scarletnova20/Power_Distribution_Board/engineering/release50/lioncircuits_review/drill/drill_report.txt

Drill report for PDB_50A.kicad_pcb
Created on 2026-09-11T23:52:39

Copper Layer Stackup:
    =============================================================
    L1 :  F.Cu                      front
    L2 :  In1.Cu                    in1
    L3 :  In2.Cu                    in2
    L4 :  B.Cu                      back

Drill file 'PDB_50A-PTH.drl' contains
    plated through holes:
    =============================================================
    T1  0.300mm  0.0118"  (343 holes))
    T2  1.000mm  0.0394"  (12 holes))

    Total plated holes count 355

Drill file 'PDB_50A-NPTH.drl' contains
    unplated through holes:
    =============================================================
    T1  3.200mm  0.1260"  (4 holes))

    Total unplated holes count 4
