scarletnova20/Power_Distribution_Board/engineering/back.png

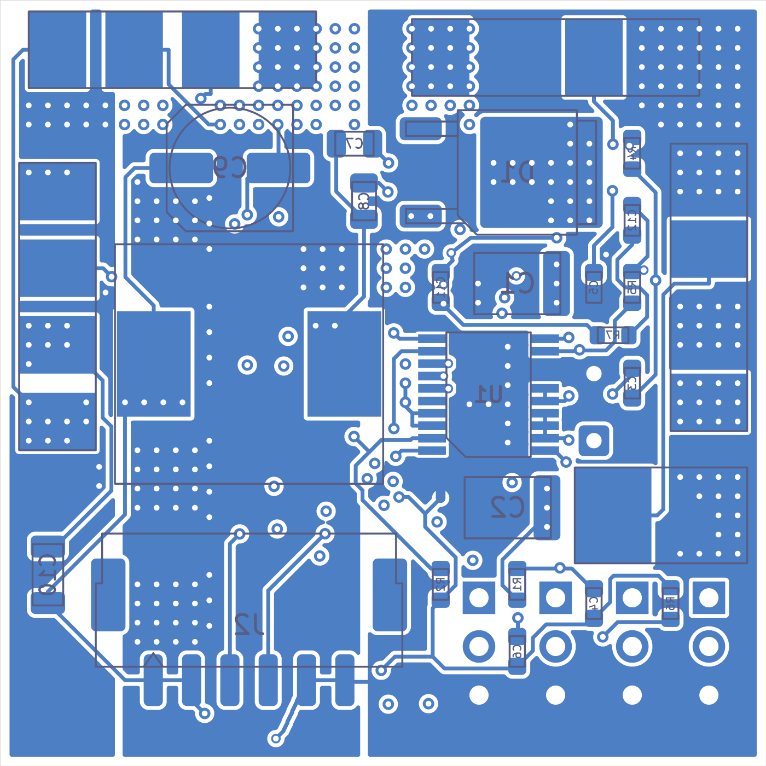
engineering/back.png
