scarletnova20/Power_Distribution_Board/engineering/datasheets/isc027n10nm6_5.png

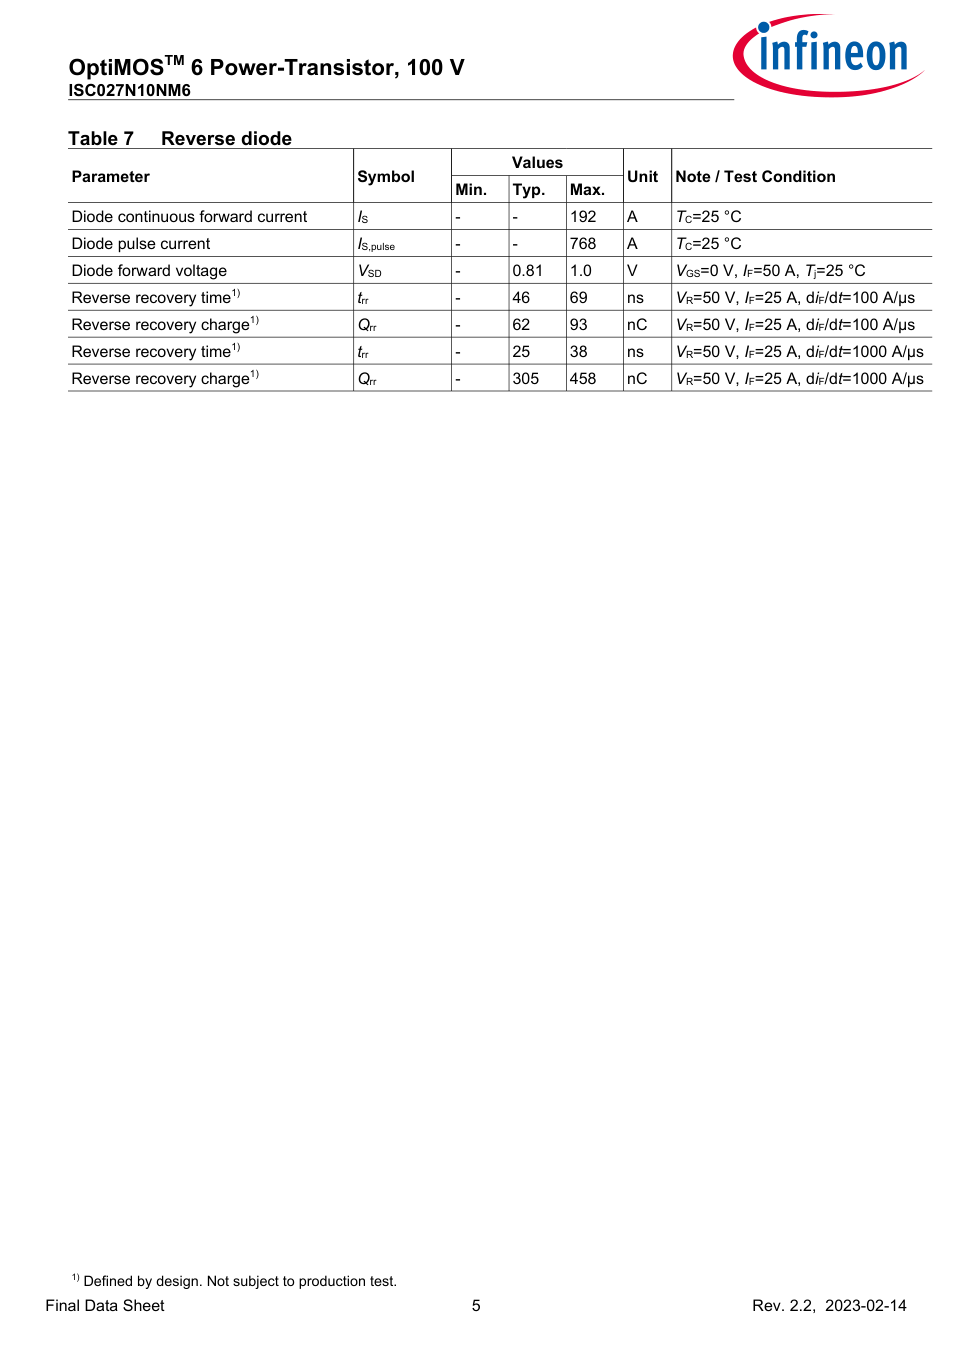
engineering/datasheets/isc027n10nm6_5.png
