scarletnova20/Power_Distribution_Board/engineering/datasheets/lm74502_12.png

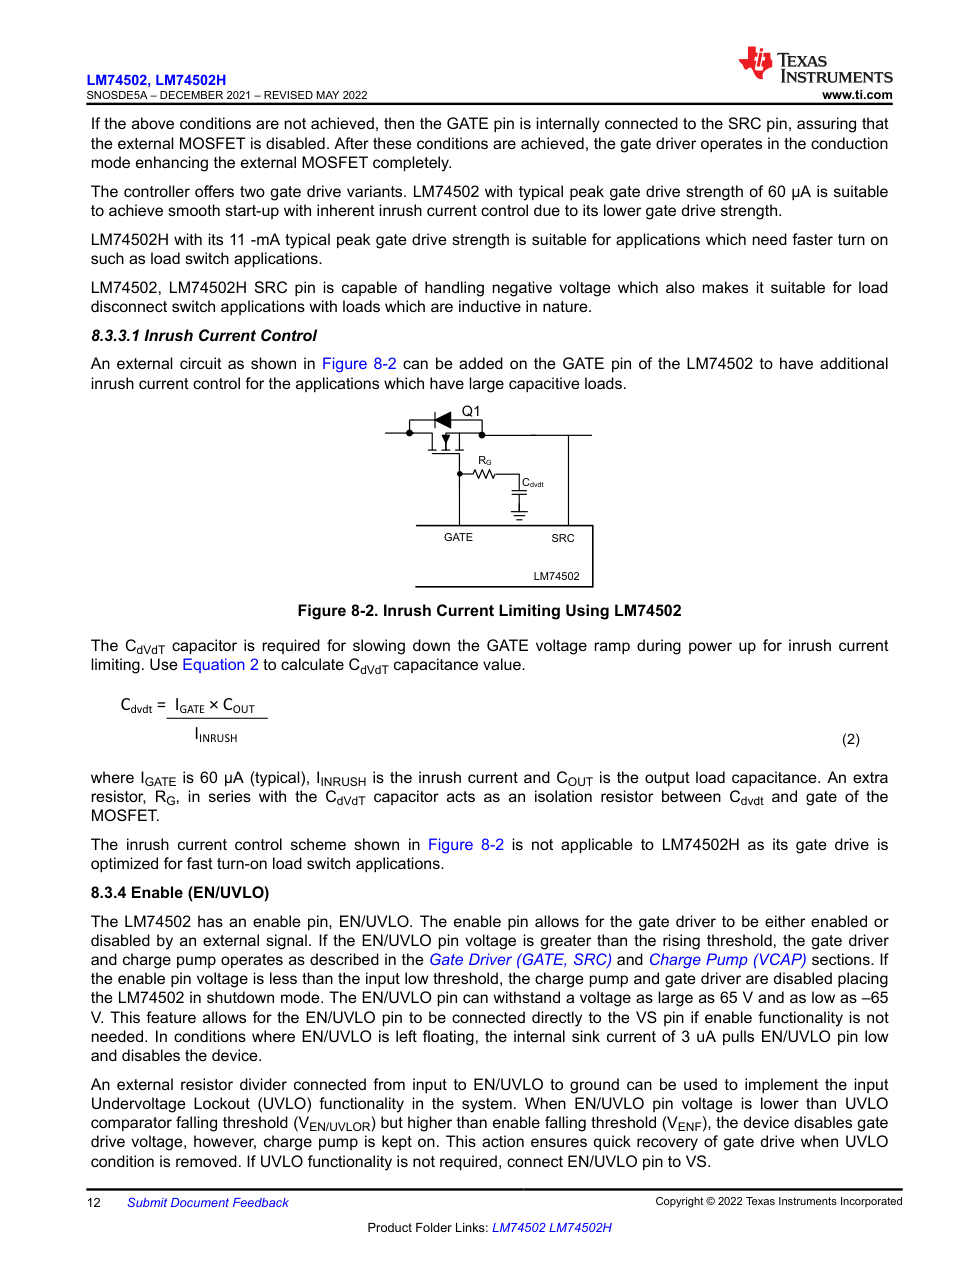
engineering/datasheets/lm74502_12.png
