scarletnova20/Power_Distribution_Board/engineering/datasheets/lm74502_27.png

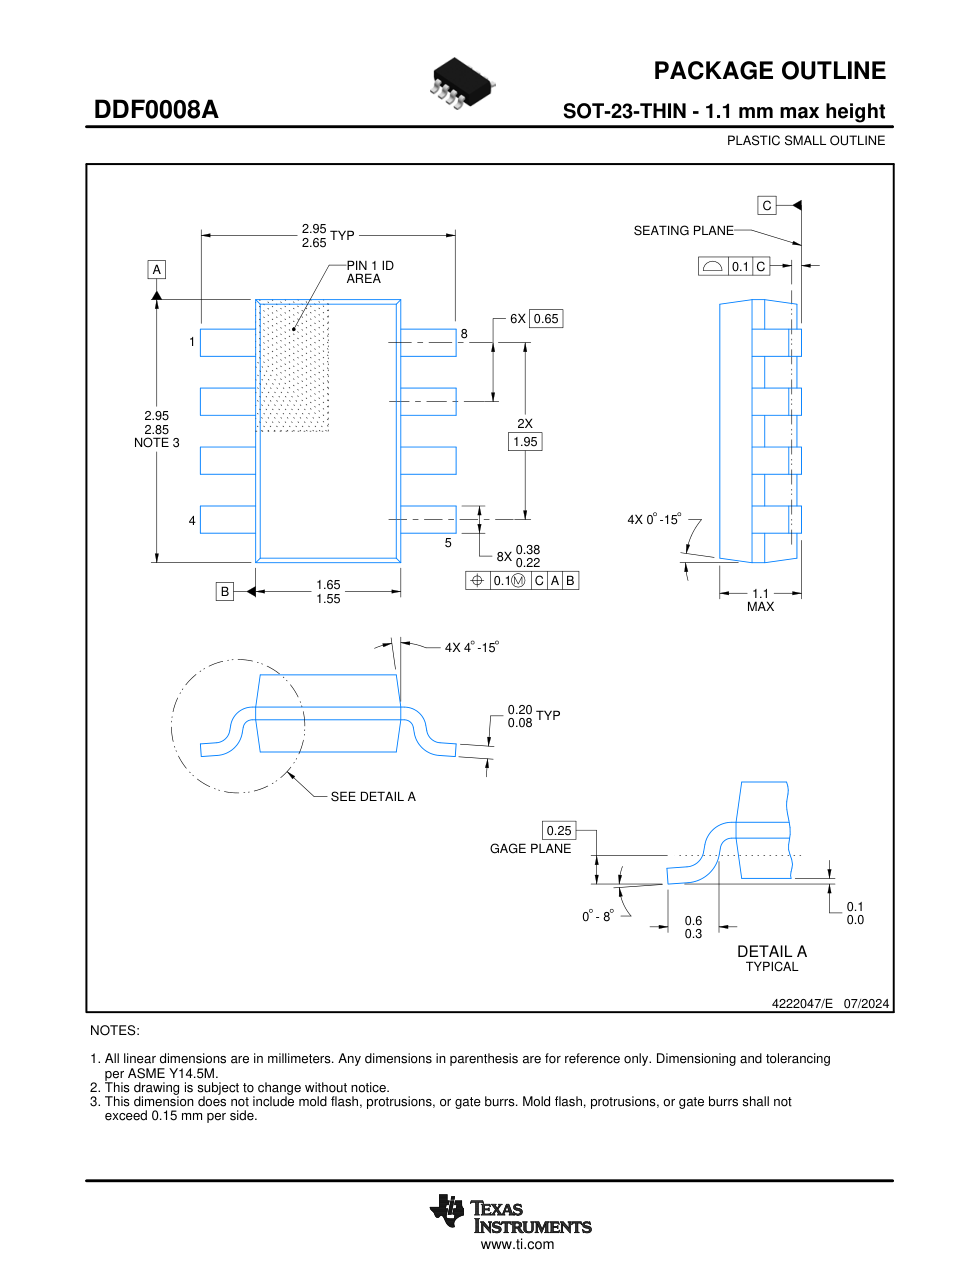
engineering/datasheets/lm74502_27.png
