scarletnova20/Power_Distribution_Board/engineering/front.png

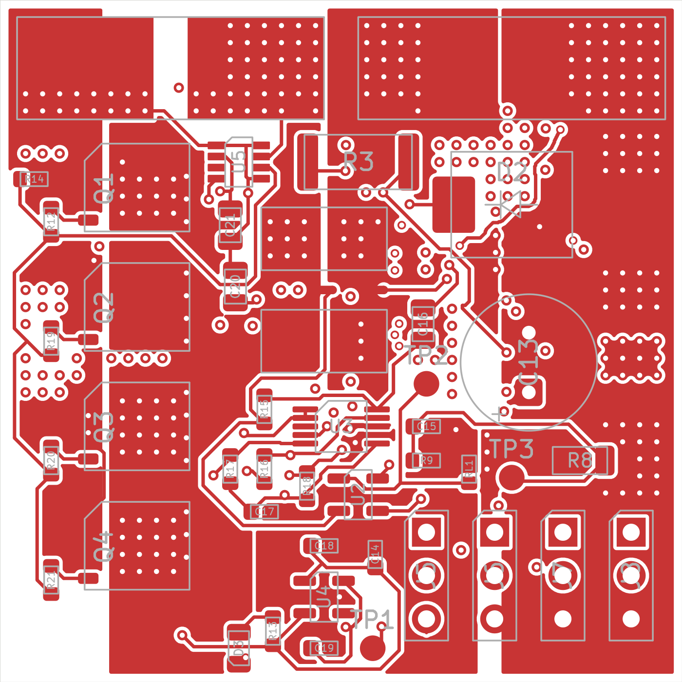
engineering/front.png
