scarletnova20/Power_Distribution_Board/engineering/local.png

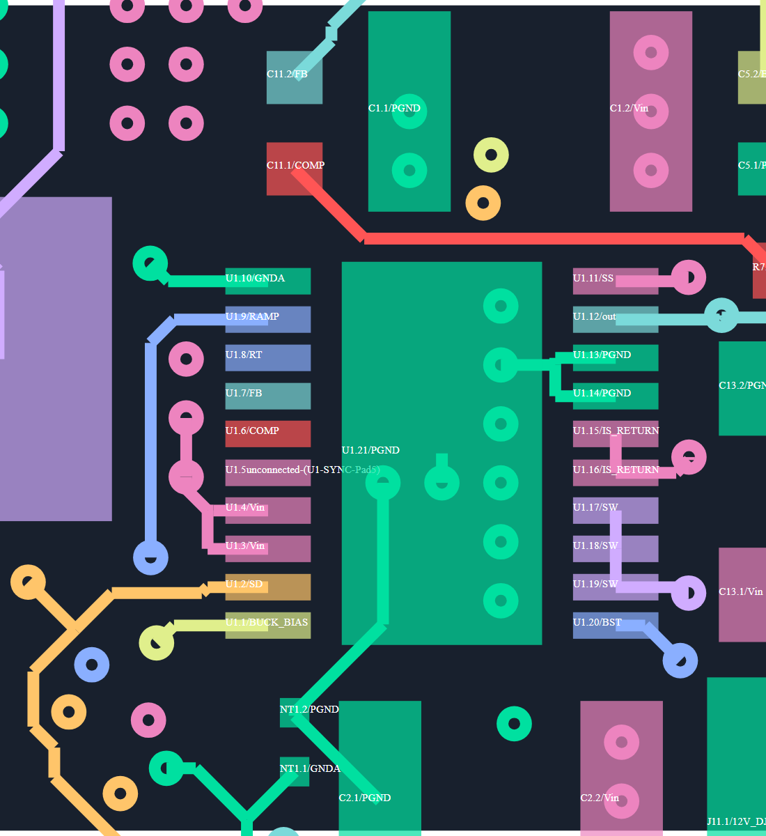
engineering/local.png
