scarletnova20/Power_Distribution_Board/engineering/release42/back.png

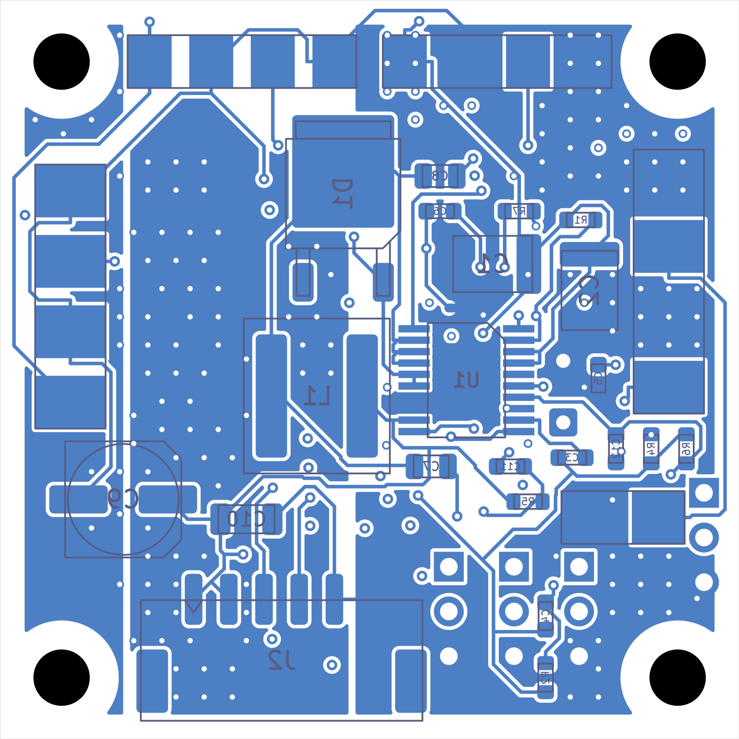
engineering/release42/back.png
