scarletnova20/Power_Distribution_Board/engineering/release42/copper_review/release_candidate-B_Cu.png

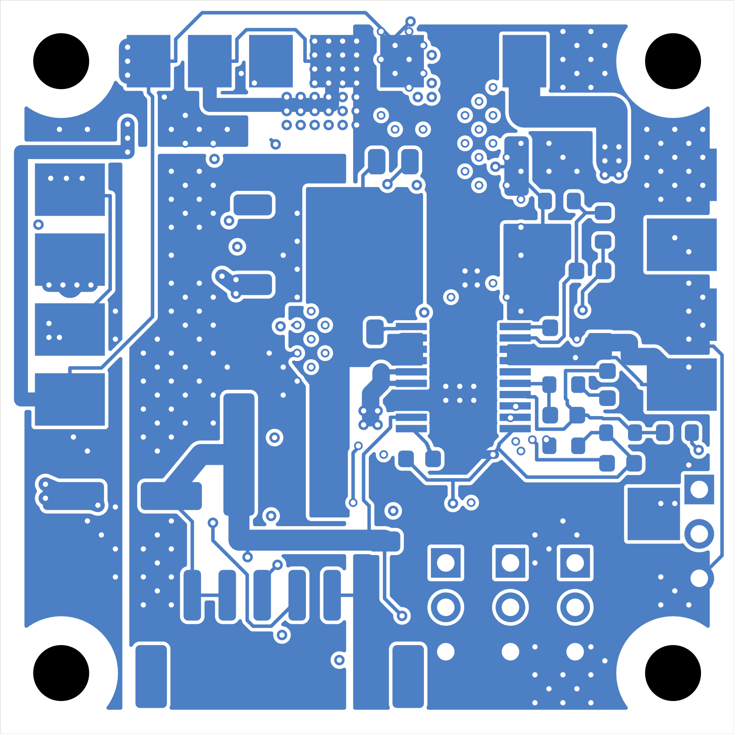
engineering/release42/copper_review/release_candidate-B_Cu.png
