scarletnova20/Power_Distribution_Board/engineering/release42/copper_review/release_candidate-In2_Cu.png

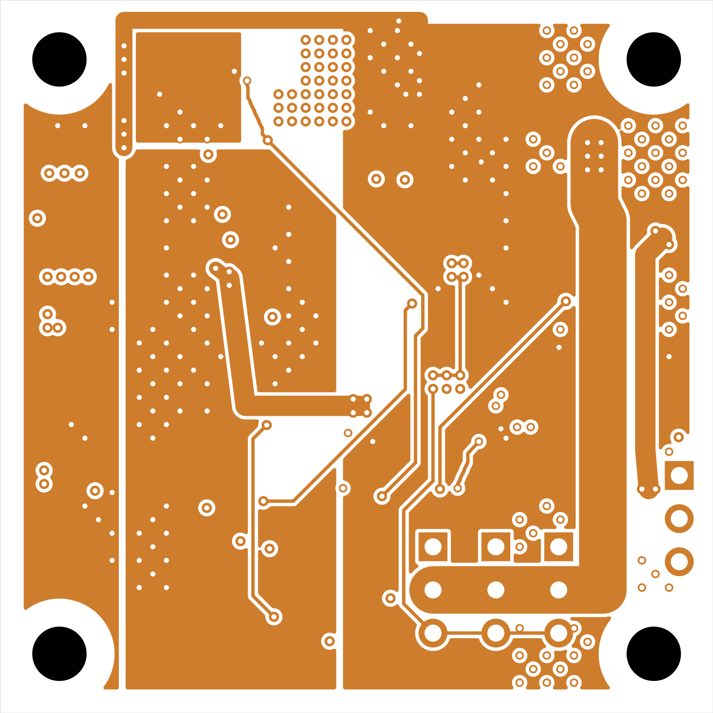
engineering/release42/copper_review/release_candidate-In2_Cu.png
