scarletnova20/Power_Distribution_Board/engineering/release42/front.png

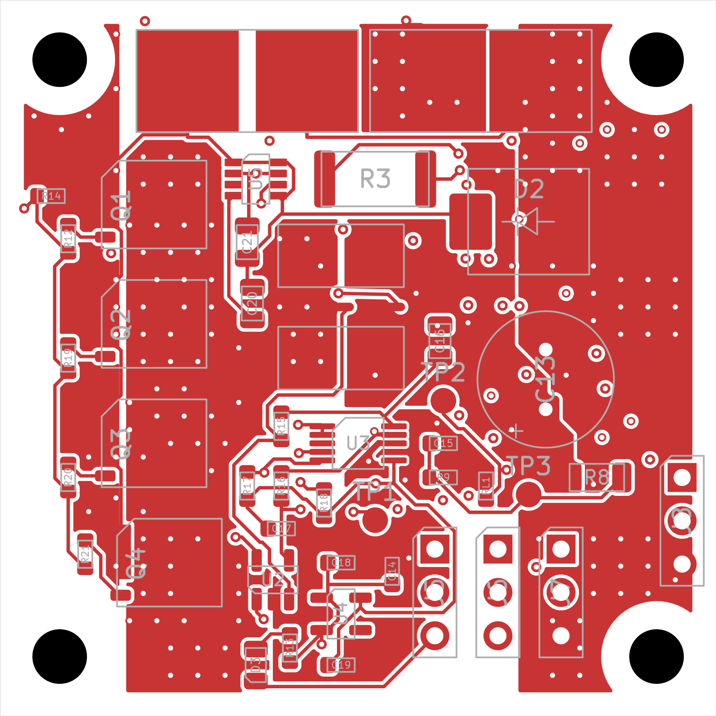
engineering/release42/front.png
