scarletnova20/Power_Distribution_Board/engineering/release42/led_review/schematic/release_candidate.png

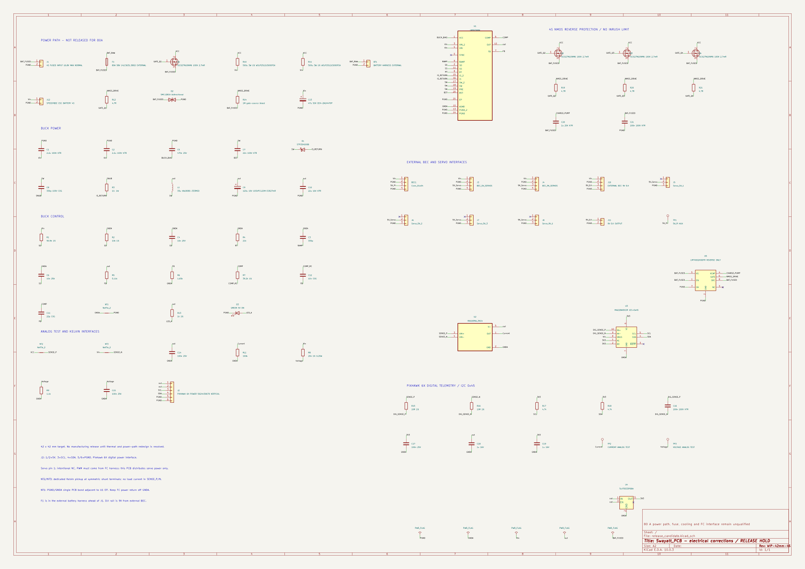
engineering/release42/led_review/schematic/release_candidate.png
