scarletnova20/Power_Distribution_Board/engineering/release42/lm5576_p36.png

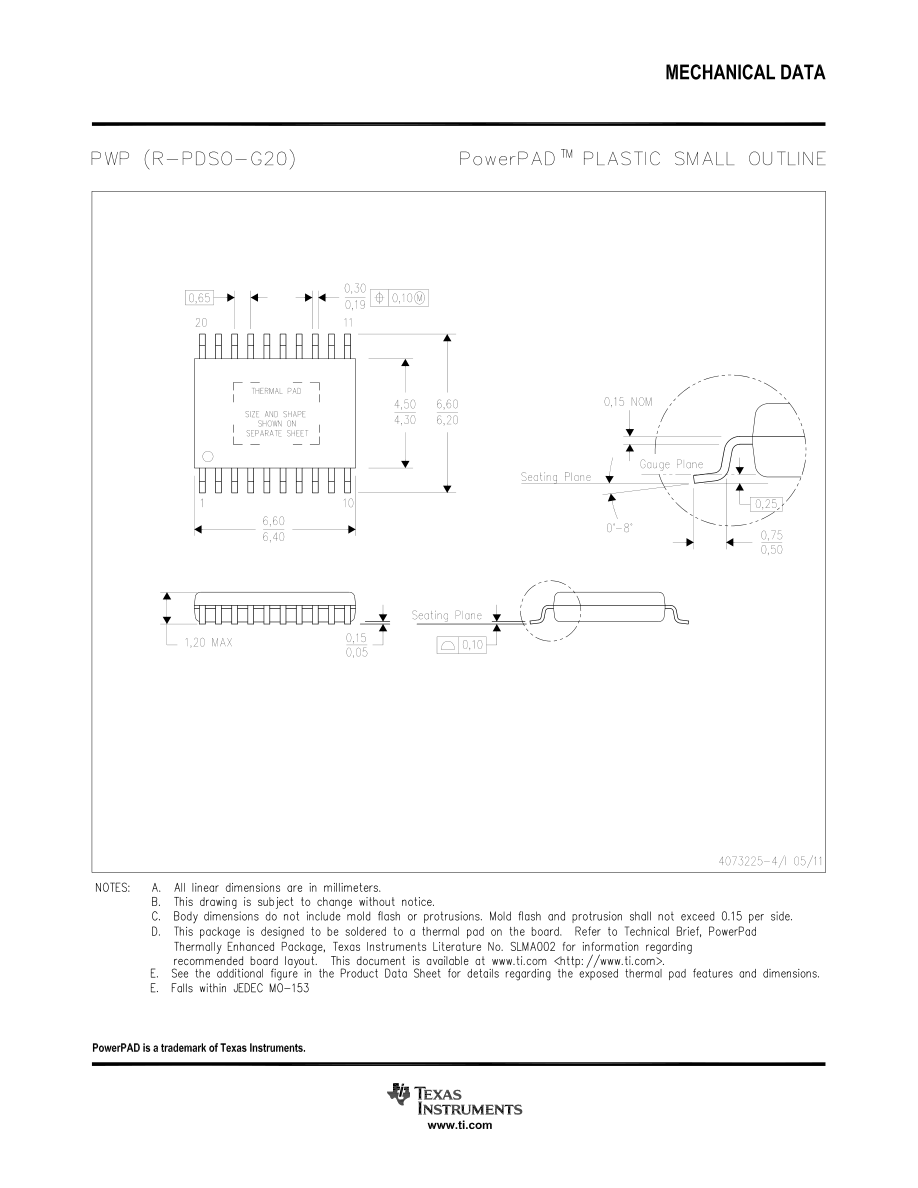
engineering/release42/lm5576_p36.png
