scarletnova20/Power_Distribution_Board/engineering/release42/panasonic_land_patterns_1.png

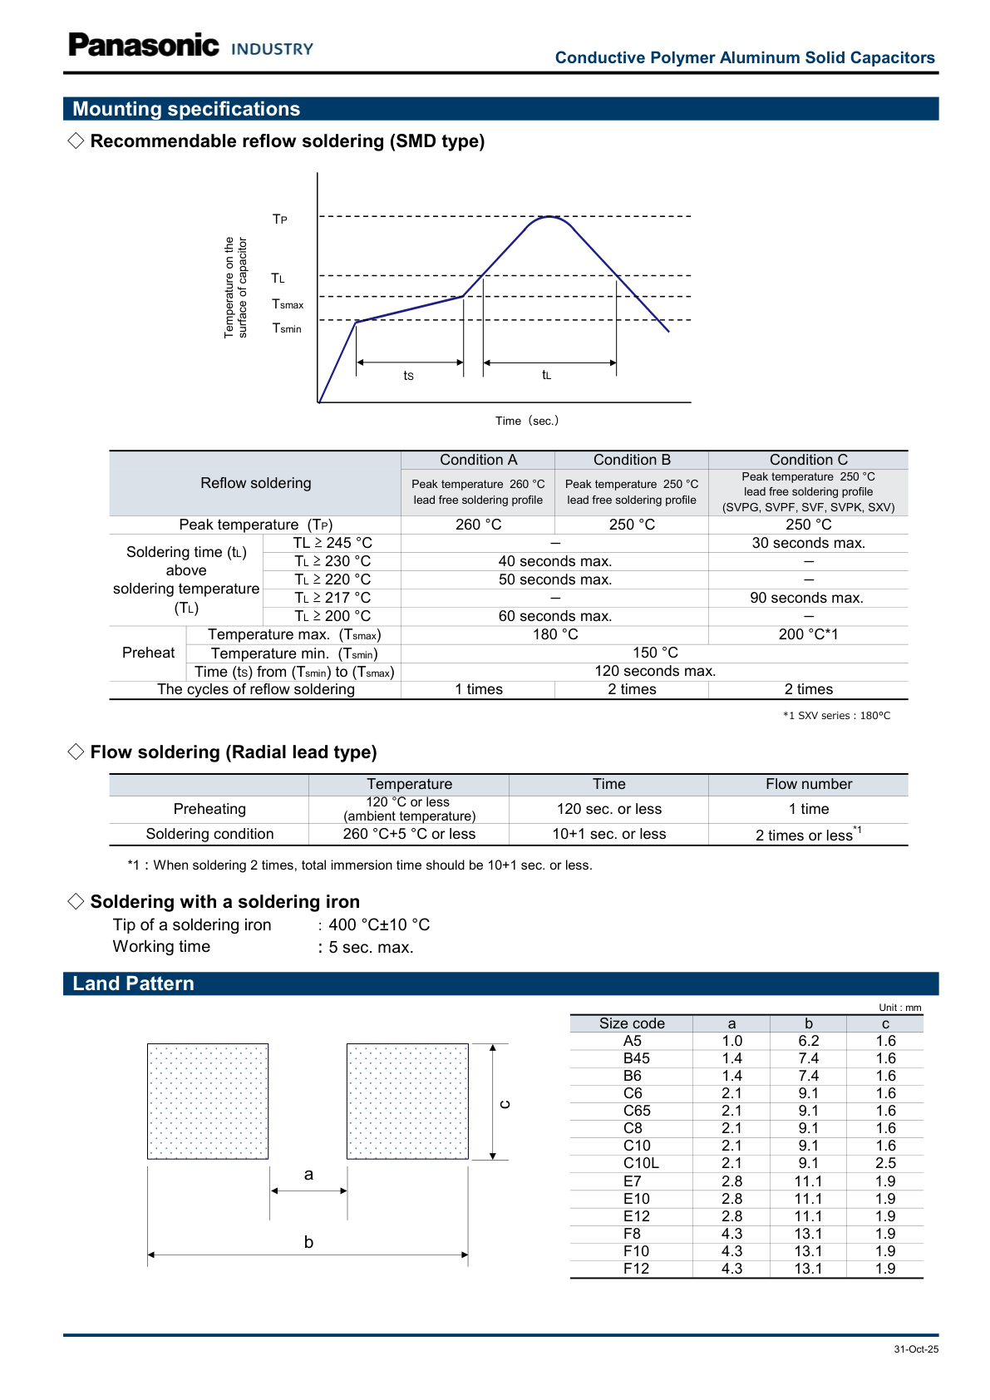
engineering/release42/panasonic_land_patterns_1.png
