scarletnova20/Power_Distribution_Board/engineering/release50/back_before_fab.png

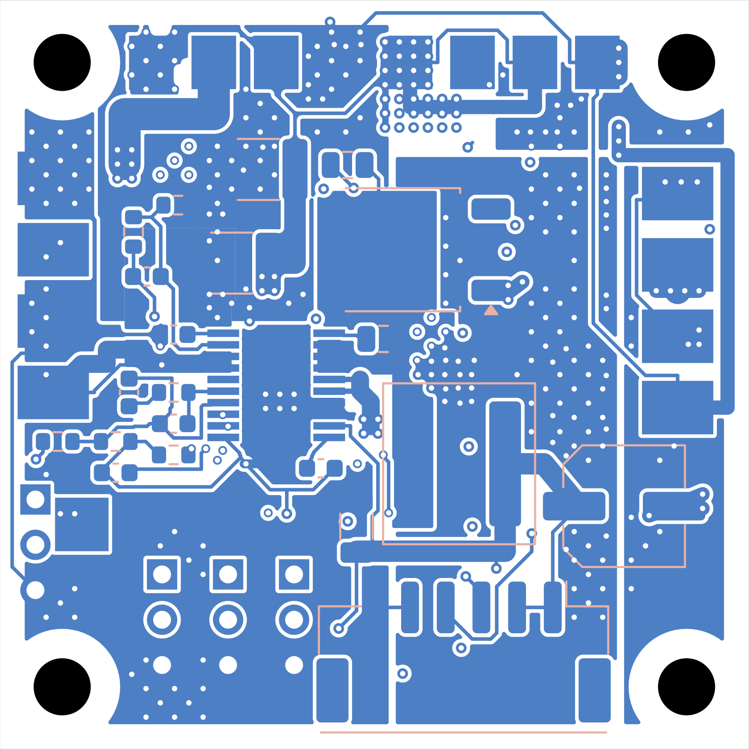
engineering/release50/back_before_fab.png
