scarletnova20/Power_Distribution_Board/engineering/release50/bec_12v_visual_review.png

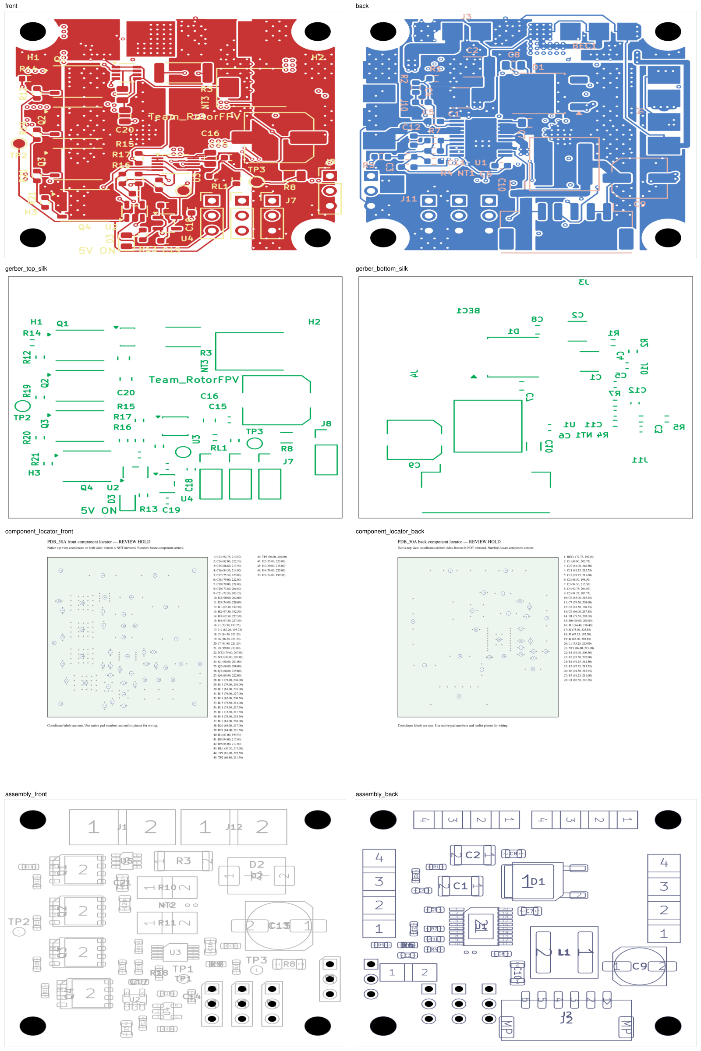
engineering/release50/bec_12v_visual_review.png
