scarletnova20/Power_Distribution_Board/engineering/release50/lioncircuits_review/previews/front.png

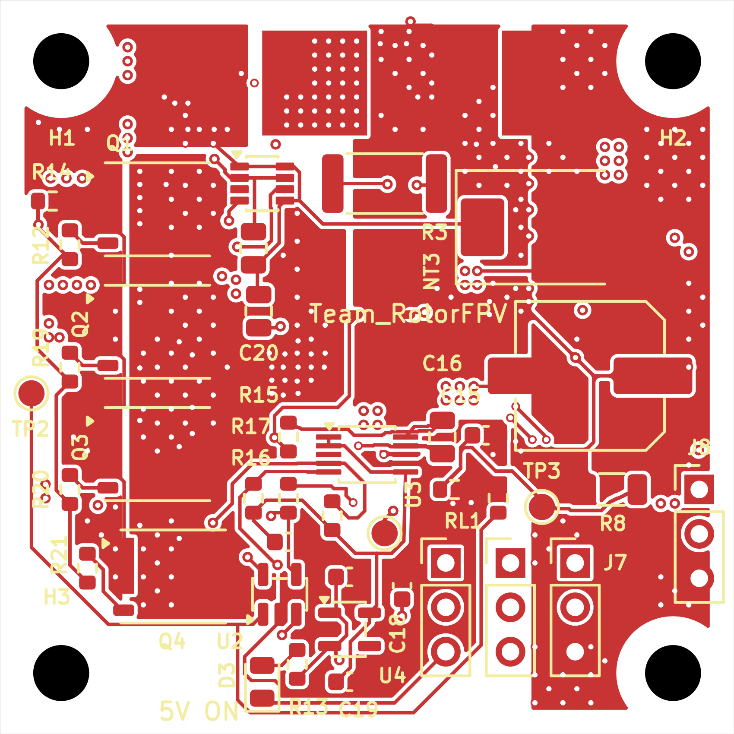
engineering/release50/lioncircuits_review/previews/front.png
