scarletnova20/Power_Distribution_Board/engineering/release50/lioncircuits_review/previews/gerber_inner_3_copper.png

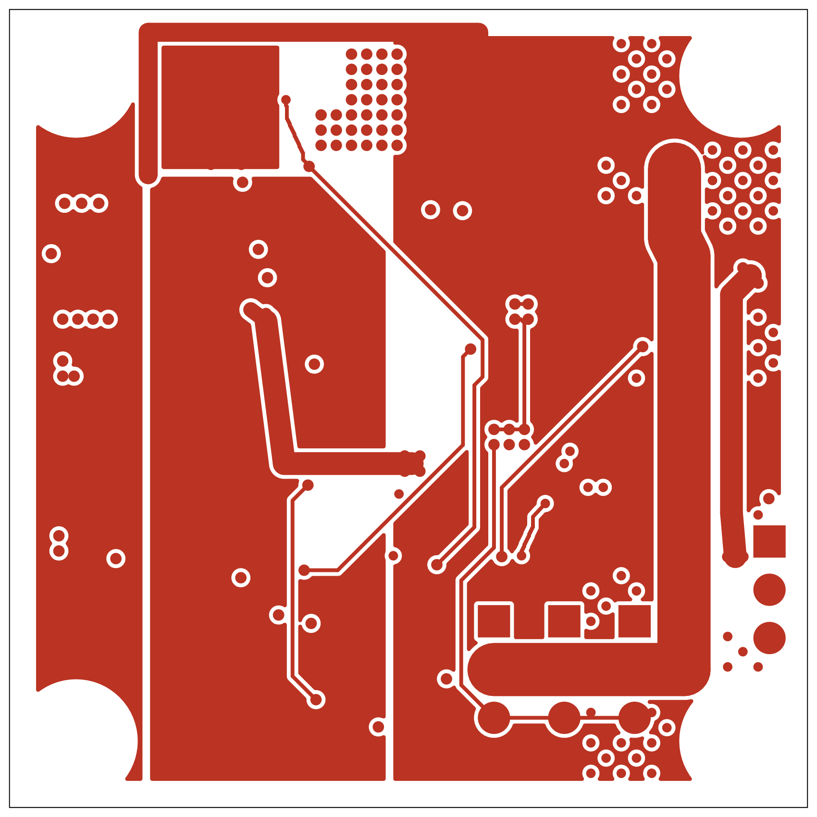
engineering/release50/lioncircuits_review/previews/gerber_inner_3_copper.png
