scarletnova20/Power_Distribution_Board/engineering/release50/lioncircuits_review/previews/gerber_top_silk.png

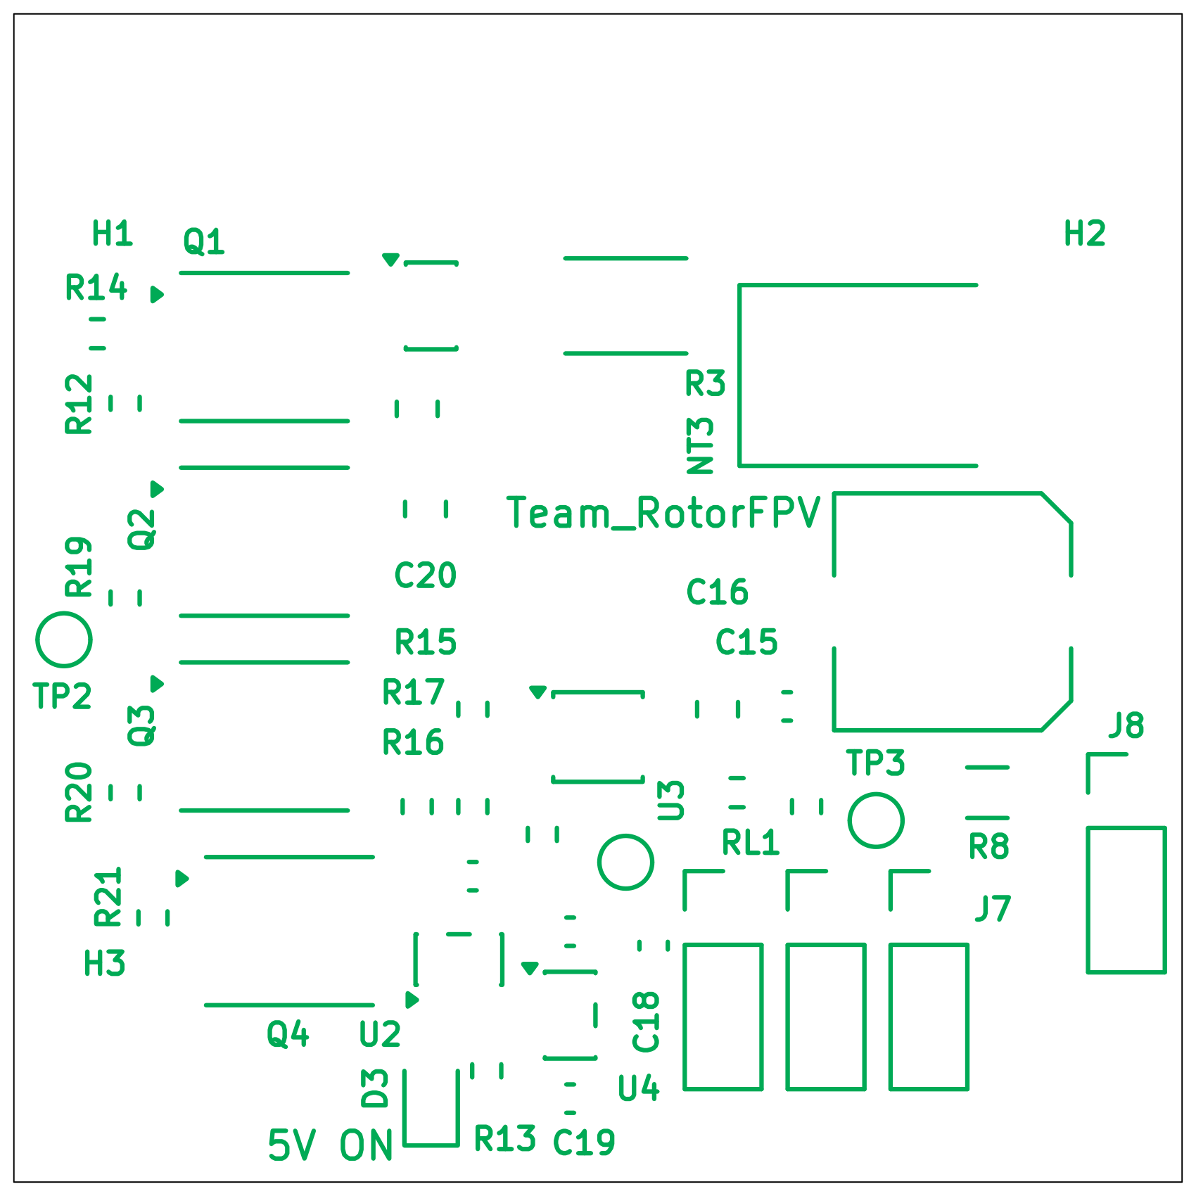
engineering/release50/lioncircuits_review/previews/gerber_top_silk.png
