scarletnova20/Power_Distribution_Board/engineering/release50/lioncircuits_review/previews/via_fill_map.png

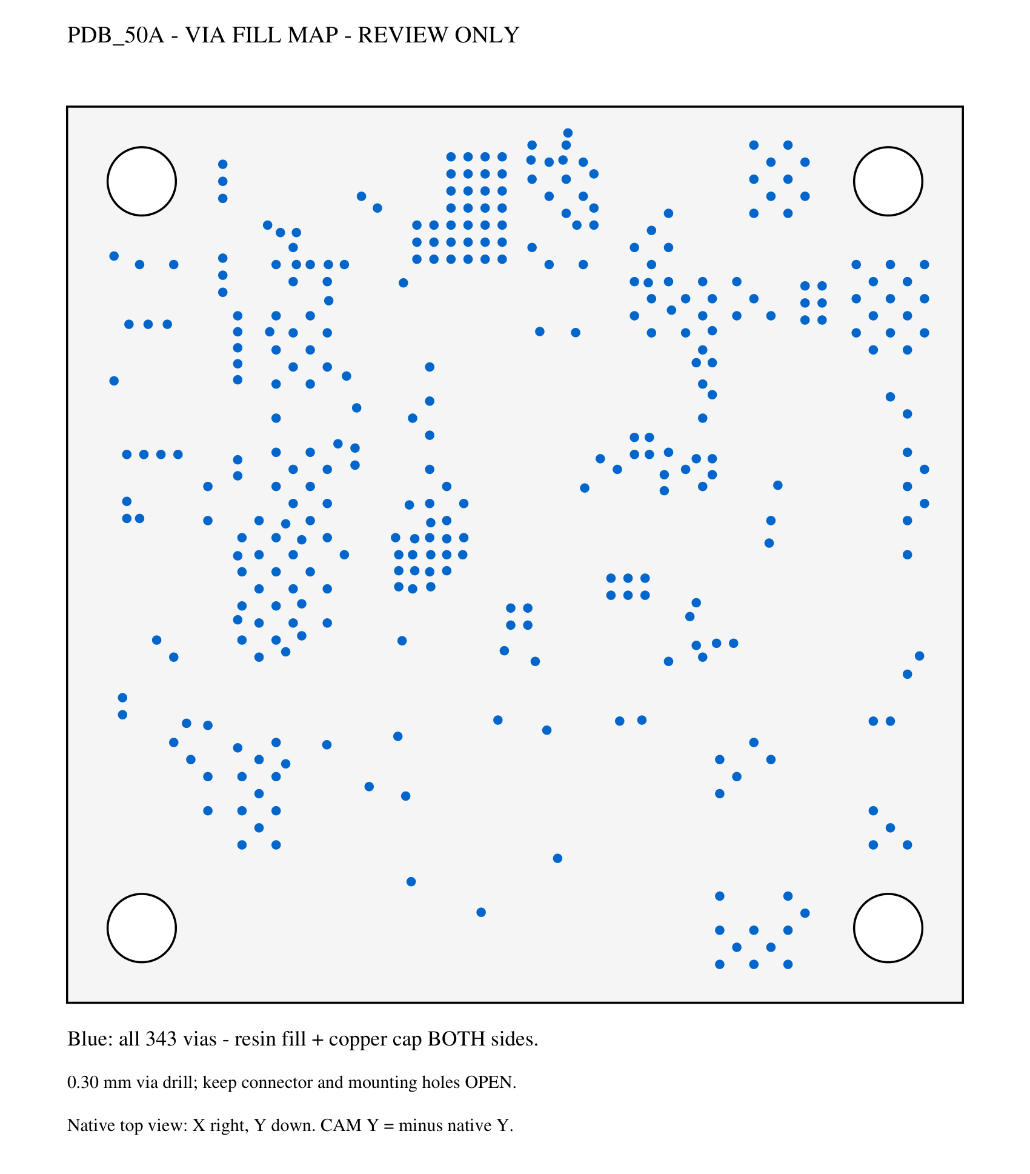
engineering/release50/lioncircuits_review/previews/via_fill_map.png
