scarletnova20/Power_Distribution_Board/engineering/schematic_preview/Swayatt_PCB.png

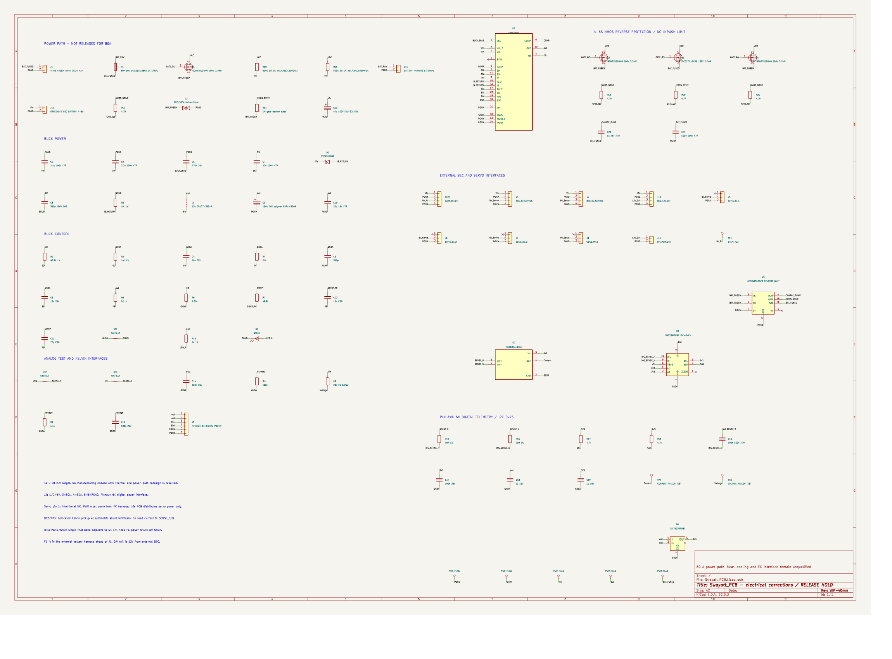
engineering/schematic_preview/Swayatt_PCB.png
