scarletnova20/Power_Distribution_Board/engineering/BOM_checkpoint.csv

Reference | Value | Footprint | Release status
BEC1 | Conn_01x04 | Swayatt_Local:BEC_Wire_4 | WORK IN PROGRESS - NOT RELEASED
BT1 | BATTERY HARNESS EXTERNAL |  | WORK IN PROGRESS - NOT RELEASED
C1 | 2.2u 100V X7R | Capacitor_SMD:C_1812_4532Metric | WORK IN PROGRESS - NOT RELEASED
C2 | 2.2u 100V X7R | Capacitor_SMD:C_1812_4532Metric | WORK IN PROGRESS - NOT RELEASED
C3 | 330p | Capacitor_SMD:C_0603_1608Metric | WORK IN PROGRESS - NOT RELEASED
C4 | 10n 25V | Capacitor_SMD:C_0603_1608Metric | WORK IN PROGRESS - NOT RELEASED
C5 | 470n 25V | Capacitor_SMD:C_0603_1608Metric | WORK IN PROGRESS - NOT RELEASED
C6 | 10n 25V | Capacitor_SMD:C_0603_1608Metric | WORK IN PROGRESS - NOT RELEASED
C7 | 22n 100V X7R | Capacitor_SMD:C_0805_2012Metric | WORK IN PROGRESS - NOT RELEASED
C8 | 330p 100V C0G | Capacitor_SMD:C_0805_2012Metric | WORK IN PROGRESS - NOT RELEASED
C9 | 150u 10V polymer ESR<=30mR | Capacitor_SMD:C_Elec_6.3x5.8 | WORK IN PROGRESS - NOT RELEASED
C10 | 22u 16V X7R | Capacitor_SMD:C_1206_3216Metric | WORK IN PROGRESS - NOT RELEASED
C11 | 22p C0G | Capacitor_SMD:C_0603_1608Metric | WORK IN PROGRESS - NOT RELEASED
C12 | 10n C0G | Capacitor_SMD:C_0603_1608Metric | WORK IN PROGRESS - NOT RELEASED
C13 | 47u 100V EEUFS2A470L | Capacitor_THT:CP_Radial_D8.0mm_P3.50mm | WORK IN PROGRESS - NOT RELEASED
C14 | 100n 25V | Capacitor_SMD:C_0603_1608Metric | WORK IN PROGRESS - NOT RELEASED
C15 | 100n 25V | Capacitor_SMD:C_0603_1608Metric | WORK IN PROGRESS - NOT RELEASED
C16 | 100n 100V X7R | Capacitor_SMD:C_0805_2012Metric | WORK IN PROGRESS - NOT RELEASED
C17 | 100n 25V | Capacitor_SMD:C_0603_1608Metric | WORK IN PROGRESS - NOT RELEASED
C18 | 1u 16V | Capacitor_SMD:C_0603_1608Metric | WORK IN PROGRESS - NOT RELEASED
C19 | 1u 16V | Capacitor_SMD:C_0603_1608Metric | WORK IN PROGRESS - NOT RELEASED
C20 | 1u 25V X7R | Capacitor_SMD:C_0805_2012Metric | WORK IN PROGRESS - NOT RELEASED
C21 | 100n 100V X7R | Capacitor_SMD:C_0805_2012Metric | WORK IN PROGRESS - NOT RELEASED
D1 | STPS5H100B | Swayatt_Local:STPS5H100B | WORK IN PROGRESS - NOT RELEASED
D2 | SMCJ28CA bidirectional | Diode_SMD:D_SMC | WORK IN PROGRESS - NOT RELEASED
D3 | GREEN | LED_SMD:LED_0805_2012Metric | WORK IN PROGRESS - NOT RELEASED
F1 | 80A 58V 142.5631.5802 EXTERNAL |  | WORK IN PROGRESS - NOT RELEASED
J1 | 4-6S FUSED INPUT 25.2V MAX | Swayatt_Local:Power_Wire_2 | WORK IN PROGRESS - NOT RELEASED
J2 | PIXHAWK 6X DIGITAL POWER | Connector_Molex:Molex_CLIK-Mate_502494-0670_1x06-1MP_P2.00mm_Horizontal | WORK IN PROGRESS - NOT RELEASED
J3 | BEC_5V_SERVOS | Swayatt_Local:BEC_Wire_4 | WORK IN PROGRESS - NOT RELEASED
J4 | BEC_9V_SERVOS | Swayatt_Local:BEC_Wire_4 | WORK IN PROGRESS - NOT RELEASED
J5 | Servo_5V_1 | Connector_PinHeader_2.54mm:PinHeader_1x03_P2.54mm_Vertical | WORK IN PROGRESS - NOT RELEASED
J6 | Servo_5V_2 | Connector_PinHeader_2.54mm:PinHeader_1x03_P2.54mm_Vertical | WORK IN PROGRESS - NOT RELEASED
J7 | Servo_5V_3 | Connector_PinHeader_2.54mm:PinHeader_1x03_P2.54mm_Vertical | WORK IN PROGRESS - NOT RELEASED
J8 | Servo_9V_1 | Connector_PinHeader_2.54mm:PinHeader_1x03_P2.54mm_Vertical | WORK IN PROGRESS - NOT RELEASED
J10 | BEC_12V_DJI | Swayatt_Local:BEC_Wire_4 | WORK IN PROGRESS - NOT RELEASED
J11 | DJI_PWR_OUT | Swayatt_Local:Aux_Wire_2 | WORK IN PROGRESS - NOT RELEASED
J12 | SPEEDYBEE ESC BATTERY 4-6S | Swayatt_Local:Power_Wire_2 | WORK IN PROGRESS - NOT RELEASED
L1 | 33u DR127-330-R | Swayatt_Local:DR127 | WORK IN PROGRESS - NOT RELEASED
NT1 | NetTie_2 | NetTie:NetTie-2_SMD_Pad0.5mm | WORK IN PROGRESS - NOT RELEASED
NT2 | NetTie_2 | NetTie:NetTie-2_SMD_Pad0.5mm | WORK IN PROGRESS - NOT RELEASED
NT3 | NetTie_2 | NetTie:NetTie-2_SMD_Pad0.5mm | WORK IN PROGRESS - NOT RELEASED
Q1 | ISC027N10NM6 100V 2.7mR | Swayatt_Local:ISC027N10NM6_GDS | WORK IN PROGRESS - NOT RELEASED
Q2 | ISC027N10NM6 100V 2.7mR | Swayatt_Local:ISC027N10NM6_GDS | WORK IN PROGRESS - NOT RELEASED
Q3 | ISC027N10NM6 100V 2.7mR | Swayatt_Local:ISC027N10NM6_GDS | WORK IN PROGRESS - NOT RELEASED
Q4 | ISC027N10NM6 100V 2.7mR | Swayatt_Local:ISC027N10NM6_GDS | WORK IN PROGRESS - NOT RELEASED
R1 | 90.9k 1% | Resistor_SMD:R_0603_1608Metric | WORK IN PROGRESS - NOT RELEASED
R2 | 10k 1% | Resistor_SMD:R_0603_1608Metric | WORK IN PROGRESS - NOT RELEASED
R3 | 10, 1W | Resistor_SMD:R_2512_6332Metric | WORK IN PROGRESS - NOT RELEASED
R4 | 21k | Resistor_SMD:R_0603_1608Metric | WORK IN PROGRESS - NOT RELEASED
R5 | 5.11k | Resistor_SMD:R_0603_1608Metric | WORK IN PROGRESS - NOT RELEASED
R6 | 1.65k | Resistor_SMD:R_0603_1608Metric | WORK IN PROGRESS - NOT RELEASED
R7 | 49.9k | Resistor_SMD:R_0603_1608Metric | WORK IN PROGRESS - NOT RELEASED
R8 | 20k 1% 0.25W | Resistor_SMD:R_1206_3216Metric | WORK IN PROGRESS - NOT RELEASED
R9 | 1.1k | Resistor_SMD:R_0603_1608Metric | WORK IN PROGRESS - NOT RELEASED
R10 | 500u 3W 1% WSLP2512L5000FEA | Swayatt_Local:WSLP2512_L5000 | WORK IN PROGRESS - NOT RELEASED
R11 | 500u 3W 1% WSLP2512L5000FEA | Swayatt_Local:WSLP2512_L5000 | WORK IN PROGRESS - NOT RELEASED
R12 | 4.7R | Resistor_SMD:R_0603_1608Metric | WORK IN PROGRESS - NOT RELEASED
R13 | 1k 1% | Resistor_SMD:R_0603_1608Metric | WORK IN PROGRESS - NOT RELEASED
R14 | 1M gate-source bleed | Resistor_SMD:R_0603_1608Metric | WORK IN PROGRESS - NOT RELEASED
R15 | 10R 1% | Resistor_SMD:R_0603_1608Metric | WORK IN PROGRESS - NOT RELEASED
R16 | 10R 1% | Resistor_SMD:R_0603_1608Metric | WORK IN PROGRESS - NOT RELEASED
R17 | 4.7k | Resistor_SMD:R_0603_1608Metric | WORK IN PROGRESS - NOT RELEASED
R18 | 4.7k | Resistor_SMD:R_0603_1608Metric | WORK IN PROGRESS - NOT RELEASED
R19 | 4.7R | Resistor_SMD:R_0603_1608Metric | WORK IN PROGRESS - NOT RELEASED
R20 | 4.7R | Resistor_SMD:R_0603_1608Metric | WORK IN PROGRESS - NOT RELEASED
R21 | 4.7R | Resistor_SMD:R_0603_1608Metric | WORK IN PROGRESS - NOT RELEASED
RL1 | 100k | Resistor_SMD:R_0603_1608Metric | WORK IN PROGRESS - NOT RELEASED
TP1 | 5V_PI AUX | TestPoint:TestPoint_Pad_D1.5mm | WORK IN PROGRESS - NOT RELEASED
TP2 | CURRENT ANALOG TEST | TestPoint:TestPoint_Pad_D1.5mm | WORK IN PROGRESS - NOT RELEASED
TP3 | VOLTAGE ANALOG TEST | TestPoint:TestPoint_Pad_D1.5mm | WORK IN PROGRESS - NOT RELEASED
U1 | LM5576MH | Package_SO:HTSSOP-20-1EP_4.4x6.5mm_P0.65mm_EP3.4x6.5mm | WORK IN PROGRESS - NOT RELEASED
U2 | INA169NA_3KG4 | Package_TO_SOT_SMD:SOT-23-5 | WORK IN PROGRESS - NOT RELEASED
U3 | INA228AIDGSR I2C=0x45 | Package_SO:MSOP-10_3x3mm_P0.5mm | WORK IN PROGRESS - NOT RELEASED
U4 | TLV75533PDBV | Package_TO_SOT_SMD:SOT-23-5 | WORK IN PROGRESS - NOT RELEASED
U5 | LM74502HDDFR REVERSE ONLY | Swayatt_Local:LM74502_DDF8 | WORK IN PROGRESS - NOT RELEASED
