scarletnova20/Power_Distribution_Board/engineering/release50/fabrication_20260915/PDB_50A-bom.csv

Refs | Value | Footprint | Qty | DNP
BEC1 | Conn_01x04 | Swayatt_Local:BEC_Wire_4_42 | 1
BT1 | BATTERY HARNESS EXTERNAL |  | 1
C1 | 2.2u 100V X7R | Capacitor_SMD:C_1812_4532Metric | 1
C2 | 2.2u 100V X7R | Capacitor_SMD:C_1812_4532Metric | 1
C3 | 330p | Capacitor_SMD:C_0603_1608Metric | 1
C4 | 10n 25V | Capacitor_SMD:C_0603_1608Metric | 1
C5 | 470n 25V | Capacitor_SMD:C_0603_1608Metric | 1
C6 | 10n 25V | Capacitor_SMD:C_0603_1608Metric | 1
C7 | 22n 100V X7R | Capacitor_SMD:C_0805_2012Metric | 1
C8 | 330p 100V C0G | Capacitor_SMD:C_0805_2012Metric | 1
C9 | 120u 10V 10SVPC120M ESR27mR | Swayatt_Local:Panasonic_OSCON_C6_10SVPC120M | 1
C10 | 22u 16V X7R | Capacitor_SMD:C_1206_3216Metric | 1
C11 | 22p C0G | Capacitor_SMD:C_0603_1608Metric | 1
C12 | 10n C0G | Capacitor_SMD:C_0603_1608Metric | 1
C13 | 47u 50V EEH-ZA1H470P | Capacitor_SMD:C_Elec_8x10.2 | 1
C14 | 100n 25V | Capacitor_SMD:C_0603_1608Metric | 1
C15 | 100n 25V | Capacitor_SMD:C_0603_1608Metric | 1
C16 | 100n 100V X7R | Capacitor_SMD:C_0805_2012Metric | 1
C17 | 100n 25V | Capacitor_SMD:C_0603_1608Metric | 1
C18 | 1u 16V | Capacitor_SMD:C_0603_1608Metric | 1
C19 | 1u 16V | Capacitor_SMD:C_0603_1608Metric | 1
C20 | 1u 25V X7R | Capacitor_SMD:C_0805_2012Metric | 1
C21 | 100n 100V X7R | Capacitor_SMD:C_0805_2012Metric | 1
D1 | STPS5H100B | Swayatt_Local:STPS5H100B | 1
D2 | SMCJ28CA bidirectional | Diode_SMD:D_SMC | 1
D3 | GREEN 5V ON | LED_SMD:LED_0805_2012Metric | 1
F1 | EXTERNAL FUSE + HOLDER TBD FOR 50A SYSTEM |  | 1
J1 | 4S FUSED INPUT 16.8V MAX NORMAL | Swayatt_Local:Power_Wire_2_42 | 1
J2 | PIXHAWK 6X POWER 5024430670 VERTICAL | Swayatt_Local:CLIK_Mate_502443_0670 | 1
J3 | BEC_5V_SERVOS | Swayatt_Local:BEC_Wire_4_42 | 1
J4 | BEC_12V_SERVOS | Swayatt_Local:BEC_Wire_4 | 1
J5 | Servo_5V_1 | Connector_PinHeader_2.54mm:PinHeader_1x03_P2.54mm_Vertical | 1
J6 | Servo_5V_2 | Connector_PinHeader_2.54mm:PinHeader_1x03_P2.54mm_Vertical | 1
J7 | Servo_5V_3 | Connector_PinHeader_2.54mm:PinHeader_1x03_P2.54mm_Vertical | 1
J8 | Servo_12V_1 | Connector_PinHeader_2.54mm:PinHeader_1x03_P2.54mm_Vertical | 1
J10 | EXTERNAL BEC 12V DJI | Swayatt_Local:BEC_Wire_4 | 1
J11 | 12V DJI OUTPUT | Swayatt_Local:Aux_Wire_2_42 | 1
J12 | SPEEDYBEE ESC BATTERY 4S | Swayatt_Local:Power_Wire_2_42 | 1
L1 | 33u XAL8080-333MED | Inductor_SMD:L_Coilcraft_XAL8080-XXX | 1
Q1 | ISC027N10NM6 100V 2.7mR | Swayatt_Local:ISC027N10NM6_GDS | 1
Q2 | ISC027N10NM6 100V 2.7mR | Swayatt_Local:ISC027N10NM6_GDS | 1
Q3 | ISC027N10NM6 100V 2.7mR | Swayatt_Local:ISC027N10NM6_GDS | 1
Q4 | ISC027N10NM6 100V 2.7mR | Swayatt_Local:ISC027N10NM6_GDS | 1
R1 | 90.9k 1% | Resistor_SMD:R_0603_1608Metric | 1
R2 | 10k 1% | Resistor_SMD:R_0603_1608Metric | 1
R3 | 10, 1W | Resistor_SMD:R_2512_6332Metric | 1
R4 | 21k | Resistor_SMD:R_0603_1608Metric | 1
R5 | 5.11k | Resistor_SMD:R_0603_1608Metric | 1
R6 | 1.65k | Resistor_SMD:R_0603_1608Metric | 1
R7 | 39.2k 1% | Resistor_SMD:R_0603_1608Metric | 1
R8 | 20k 1% 0.25W | Resistor_SMD:R_1206_3216Metric | 1
R9 | 1.1k | Resistor_SMD:R_0603_1608Metric | 1
R10 | 500u 3W 1% WSLP2512L5000FEA | Swayatt_Local:WSLP2512_L5000 | 1
R11 | 500u 3W 1% WSLP2512L5000FEA | Swayatt_Local:WSLP2512_L5000 | 1
R12 | 4.7R | Resistor_SMD:R_0603_1608Metric | 1
R13 | 1k 1% | Resistor_SMD:R_0603_1608Metric | 1
R14 | 1M gate-source bleed | Resistor_SMD:R_0603_1608Metric | 1
R15 | 10R 1% | Resistor_SMD:R_0603_1608Metric | 1
R16 | 10R 1% | Resistor_SMD:R_0603_1608Metric | 1
R17 | 4.7k | Resistor_SMD:R_0603_1608Metric | 1
R18 | 4.7k | Resistor_SMD:R_0603_1608Metric | 1
R19 | 4.7R | Resistor_SMD:R_0603_1608Metric | 1
R20 | 4.7R | Resistor_SMD:R_0603_1608Metric | 1
R21 | 4.7R | Resistor_SMD:R_0603_1608Metric | 1
RL1 | 100k | Resistor_SMD:R_0603_1608Metric | 1
TP1 | 5V_PI AUX | TestPoint:TestPoint_Pad_D1.5mm | 1
TP2 | CURRENT ANALOG TEST | TestPoint:TestPoint_Pad_D1.5mm | 1
TP3 | VOLTAGE ANALOG TEST | TestPoint:TestPoint_Pad_D1.5mm | 1
U1 | LM5576MH | Swayatt_Local:LM5576_PWP20 | 1
U2 | INA169NA_3KG4 | Package_TO_SOT_SMD:SOT-23-5 | 1
U3 | INA228AIDGSR I2C=0x45 | Swayatt_Local:INA228_DGS0010A | 1
U4 | TLV75533PDBV | Package_TO_SOT_SMD:SOT-23-5 | 1
U5 | LM74502HDDFR REVERSE ONLY | Swayatt_Local:LM74502_DDF8 | 1
