scarletnova20/Power_Distribution_Board/Swayatt_PCB.csv

Id | Designator | Footprint | Quantity | Designation | Supplier and ref
1 | BEC1 | BEC_Wire_4 | 1 | Conn_01x04
2 | C1, C2 | C_1812_4532Metric | 2 | 2.2u 100V X7R
3 | C3 | C_0603_1608Metric | 1 | 330p
4 | C4, C6 | C_0603_1608Metric | 2 | 10n 25V
5 | C5 | C_0603_1608Metric | 1 | 470n 25V
6 | C7 | C_0805_2012Metric | 1 | 22n 100V X7R
7 | C8 | C_0805_2012Metric | 1 | 330p 100V C0G
8 | C9 | C_Elec_6.3x5.8 | 1 | 150u 10V polymer ESR<=30mR
9 | C10 | C_1206_3216Metric | 1 | 22u 16V X7R
10 | C11 | C_0603_1608Metric | 1 | 22p C0G
11 | C12 | C_0603_1608Metric | 1 | 10n C0G
12 | C13 | CP_Radial_D8.0mm_P3.50mm | 1 | 47u 100V EEUFS2A470L
13 | C14, C15, C17 | C_0603_1608Metric | 3 | 100n 25V
14 | C16, C21 | C_0805_2012Metric | 2 | 100n 100V X7R
15 | C18, C19 | C_0603_1608Metric | 2 | 1u 16V
16 | C20 | C_0805_2012Metric | 1 | 1u 25V X7R
17 | D1 | STPS5H100B | 1 | STPS5H100B
18 | D2 | D_SMC | 1 | SMCJ28CA bidirectional
19 | D3 | LED_0805_2012Metric | 1 | GREEN
20 | J1 | Power_Wire_2 | 1 | 4-6S FUSED INPUT 25.2V MAX
21 | J2 | Molex_CLIK-Mate_502494-0670_1x06-1MP_P2.00mm_Horizontal | 1 | PIXHAWK 6X DIGITAL POWER
22 | J3 | BEC_Wire_4 | 1 | BEC_5V_SERVOS
23 | J4 | BEC_Wire_4 | 1 | BEC_9V_SERVOS
24 | J5 | PinHeader_1x03_P2.54mm_Vertical | 1 | Servo_5V_1
25 | J6 | PinHeader_1x03_P2.54mm_Vertical | 1 | Servo_5V_2
26 | J7 | PinHeader_1x03_P2.54mm_Vertical | 1 | Servo_5V_3
27 | J8 | PinHeader_1x03_P2.54mm_Vertical | 1 | Servo_9V_1
28 | J10 | BEC_Wire_4 | 1 | BEC_12V_DJI
29 | J11 | Aux_Wire_2 | 1 | DJI_PWR_OUT
30 | J12 | Power_Wire_2 | 1 | SPEEDYBEE ESC BATTERY 4-6S
31 | L1 | DR127 | 1 | 33u DR127-330-R
32 | Q1, Q2, Q3, Q4 | ISC027N10NM6_GDS | 4 | ISC027N10NM6 100V 2.7mR
33 | R1 | R_0603_1608Metric | 1 | 90.9k 1%
34 | R2 | R_0603_1608Metric | 1 | 10k 1%
35 | R3 | R_2512_6332Metric | 1 | 10, 1W
36 | R4 | R_0603_1608Metric | 1 | 21k
37 | R5 | R_0603_1608Metric | 1 | 5.11k
38 | R6 | R_0603_1608Metric | 1 | 1.65k
39 | R7 | R_0603_1608Metric | 1 | 49.9k
40 | R8 | R_1206_3216Metric | 1 | 20k 1% 0.25W
41 | R9 | R_0603_1608Metric | 1 | 1.1k
42 | R10, R11 | WSLP2512_L5000 | 2 | 500u 3W 1% WSLP2512L5000FEA
43 | R12, R19, R20, R21 | R_0603_1608Metric | 4 | 4.7R
44 | R13 | R_0603_1608Metric | 1 | 1k 1%
45 | R14 | R_0603_1608Metric | 1 | 1M gate-source bleed
46 | R15, R16 | R_0603_1608Metric | 2 | 10R 1%
47 | R17, R18 | R_0603_1608Metric | 2 | 4.7k
48 | RL1 | R_0603_1608Metric | 1 | 100k
49 | U1 | HTSSOP-20-1EP_4.4x6.5mm_P0.65mm_EP3.4x6.5mm | 1 | LM5576MH
50 | U2 | SOT-23-5 | 1 | INA169NA_3KG4
51 | U3 | MSOP-10_3x3mm_P0.5mm | 1 | INA228AIDGSR I2C=0x45
52 | U4 | SOT-23-5 | 1 | TLV75533PDBV
53 | U5 | LM74502_DDF8 | 1 | LM74502HDDFR REVERSE ONLY
