scarletnova20/Power_Distribution_Board/engineering/release50/lioncircuits_review/pad_coordinates.csv

reference | pin | net | side | x_mm | y_mm | kind | size_mm
R9 | 1 | /Voltage | F.Cu | 84.175 | 217.0 | smd | [0.8, 0.95]
R9 | 2 | /GNDA | F.Cu | 85.825 | 217.0 | smd | [0.8, 0.95]
U3 | 1 | /3V3 | F.Cu | 77.8 | 214.0 | smd | [1.45, 0.3]
U3 | 2 | /3V3 | F.Cu | 77.8 | 214.5 | smd | [1.45, 0.3]
U3 | 3 | unconnected-(U3-~{ALERT}-Pad3) | F.Cu | 77.8 | 215.0 | smd | [1.45, 0.3]
U3 | 4 | /SDA | F.Cu | 77.8 | 215.5 | smd | [1.45, 0.3]
U3 | 5 | /SCL | F.Cu | 77.8 | 216.0 | smd | [1.45, 0.3]
U3 | 6 | /3V3 | F.Cu | 82.2 | 216.0 | smd | [1.45, 0.3]
U3 | 7 | /GNDA | F.Cu | 82.2 | 215.5 | smd | [1.45, 0.3]
U3 | 8 | /Vin | F.Cu | 82.2 | 215.0 | smd | [1.45, 0.3]
U3 | 9 | /DIG_SENSE_N | F.Cu | 82.2 | 214.5 | smd | [1.45, 0.3]
U3 | 10 | /DIG_SENSE_P | F.Cu | 82.2 | 214.0 | smd | [1.45, 0.3]
RL1 | 1 | /Current | F.Cu | 87.5 | 218.325 | smd | [0.8, 0.95]
RL1 | 2 | /GNDA | F.Cu | 87.5 | 216.675 | smd | [0.8, 0.95]
R20 | 1 | /NMOS_DRIVE | F.Cu | 63.0 | 217.825 | smd | [0.8, 0.95]
R20 | 2 | /GATE_Q3 | F.Cu | 63.0 | 216.175 | smd | [0.8, 0.95]
J6 | 1 | unconnected-(J6-Pin_1-Pad1) | F.Cu | 88.2 | 221.2 | thru_hole | [1.7, 1.7]
J6 | 2 | /5V_Servo | F.Cu | 88.2 | 223.74 | thru_hole | [1.7, 1.7]
J6 | 3 | /PGND | F.Cu | 88.2 | 226.28 | thru_hole | [1.7, 1.7]
C15 | 1 | /Voltage | F.Cu | 86.025 | 213.9 | smd | [0.9, 0.95]
C15 | 2 | /GNDA | F.Cu | 87.575 | 213.9 | smd | [0.9, 0.95]
U5 | 1 | /BAT_FUSED | F.Cu | 72.7 | 198.525 | smd | [1.05, 0.45]
U5 | 2 | /PGND | F.Cu | 72.7 | 199.175 | smd | [1.05, 0.45]
U5 | 3 | unconnected-(U5-NC-Pad3) | F.Cu | 72.7 | 199.825 | smd | [1.05, 0.45]
U5 | 4 | /CHARGE_PUMP | F.Cu | 72.7 | 200.475 | smd | [1.05, 0.45]
U5 | 5 | /BAT_FUSED | F.Cu | 75.3 | 200.475 | smd | [1.05, 0.45]
U5 | 6 | /NMOS_DRIVE | F.Cu | 75.3 | 199.825 | smd | [1.05, 0.45]
U5 | 7 | /PGND | F.Cu | 75.3 | 199.175 | smd | [1.05, 0.45]
U5 | 8 | /BAT_FUSED | F.Cu | 75.3 | 198.525 | smd | [1.05, 0.45]
C21 | 1 | /BAT_FUSED | F.Cu | 73.5 | 204.15 | smd | [1.0, 1.45]
C21 | 2 | /PGND | F.Cu | 73.5 | 202.25 | smd | [1.0, 1.45]
TP2 | 1 | /Current | F.Cu | 60.8 | 211.5 | smd | [1.5, 1.5]
H1 |  |  | F.Cu | 62.5 | 192.5 | np_thru_hole | [3.2, 3.2]
H3 |  |  | F.Cu | 62.5 | 227.5 | np_thru_hole | [3.2, 3.2]
R3 | 1 | /SNUB | F.Cu | 78.0375 | 199.5 | smd | [1.225, 3.35]
R3 | 2 | /IS_RETURN | F.Cu | 83.9625 | 199.5 | smd | [1.225, 3.35]
TP1 | 1 | /5V_PI | F.Cu | 81.0 | 219.5 | smd | [1.5, 1.5]
C18 | 1 | /out | F.Cu | 78.225 | 222.0 | smd | [0.9, 0.95]
C18 | 2 | /GNDA | F.Cu | 79.775 | 222.0 | smd | [0.9, 0.95]
R10 | 1 | /VCC | F.Cu | 76.84 | 204.0 | smd | [3.05, 3.68]
R10 | 2 | /Vin | F.Cu | 81.16 | 204.0 | smd | [3.05, 3.68]
Q1 |  |  | F.Cu | 67.2 | 199.275 | smd | [0.9, 0.9]
Q1 |  |  | F.Cu | 67.2 | 200.425 | smd | [0.9, 0.9]
Q1 |  |  | F.Cu | 67.2 | 201.575 | smd | [0.9, 0.9]
Q1 |  |  | F.Cu | 67.2 | 202.725 | smd | [0.9, 0.9]
Q1 |  |  | F.Cu | 68.425 | 199.275 | smd | [0.9, 0.9]
Q1 |  |  | F.Cu | 68.425 | 200.425 | smd | [0.9, 0.9]
Q1 |  |  | F.Cu | 68.425 | 201.575 | smd | [0.9, 0.9]
Q1 |  |  | F.Cu | 68.425 | 202.725 | smd | [0.9, 0.9]
Q1 |  |  | F.Cu | 69.625 | 199.275 | smd | [0.9, 0.9]
Q1 |  |  | F.Cu | 69.625 | 200.425 | smd | [0.9, 0.9]
Q1 |  |  | F.Cu | 69.625 | 201.575 | smd | [0.9, 0.9]
Q1 |  |  | F.Cu | 69.625 | 202.725 | smd | [0.9, 0.9]
Q1 | 1 | /GATE_Q1 | F.Cu | 65.175 | 202.905 | smd | [1.2, 0.65]
Q1 | 2 | /VCC | F.Cu | 68.675 | 201.0 | smd | [4.5, 4.7]
Q1 | 2 | /VCC | F.Cu | 70.925 | 199.005 | smd | [1.0, 0.7]
Q1 | 2 | /VCC | F.Cu | 70.925 | 200.335 | smd | [1.0, 0.7]
Q1 | 2 | /VCC | F.Cu | 70.925 | 201.665 | smd | [1.0, 0.7]
Q1 | 2 | /VCC | F.Cu | 70.925 | 202.995 | smd | [1.0, 0.7]
Q1 | 3 | /BAT_FUSED | F.Cu | 65.175 | 199.095 | smd | [1.2, 0.65]
Q1 | 3 | /BAT_FUSED | F.Cu | 65.175 | 200.365 | smd | [1.2, 0.65]
Q1 | 3 | /BAT_FUSED | F.Cu | 65.175 | 200.365 | smd | [1.2, 3.19]
Q1 | 3 | /BAT_FUSED | F.Cu | 65.175 | 201.635 | smd | [1.2, 0.65]
R19 | 1 | /NMOS_DRIVE | F.Cu | 63.0 | 210.825 | smd | [0.8, 0.95]
R19 | 2 | /GATE_Q2 | F.Cu | 63.0 | 209.175 | smd | [0.8, 0.95]
J1 | 1 | /BAT_FUSED | F.Cu | 70.0 | 193.75 | smd | [6.0, 6.0]
J1 | 2 | /PGND | F.Cu | 77.0 | 193.75 | smd | [6.0, 6.0]
R13 | 1 | /out | F.Cu | 76.0 | 227.825 | smd | [0.8, 0.95]
R13 | 2 | /LED_A | F.Cu | 76.0 | 226.175 | smd | [0.8, 0.95]
H2 |  |  | F.Cu | 97.5 | 192.5 | np_thru_hole | [3.2, 3.2]
U4 | 1 | /out | F.Cu | 77.8625 | 224.05 | smd | [1.325, 0.6]
U4 | 2 | /GNDA | F.Cu | 77.8625 | 225.0 | smd | [1.325, 0.6]
U4 | 3 | /out | F.Cu | 77.8625 | 225.95 | smd | [1.325, 0.6]
U4 | 4 | unconnected-(U4-NC-Pad4) | F.Cu | 80.1375 | 225.95 | smd | [1.325, 0.6]
U4 | 5 | /3V3 | F.Cu | 80.1375 | 224.05 | smd | [1.325, 0.6]
J7 | 1 | unconnected-(J7-Pin_1-Pad1) | F.Cu | 91.9 | 221.2 | thru_hole | [1.7, 1.7]
J7 | 2 | /5V_Servo | F.Cu | 91.9 | 223.74 | thru_hole | [1.7, 1.7]
J7 | 3 | /PGND | F.Cu | 91.9 | 226.28 | thru_hole | [1.7, 1.7]
H4 |  |  | F.Cu | 97.5 | 227.5 | np_thru_hole | [3.2, 3.2]
J8 | 1 | unconnected-(J8-Pin_1-Pad1) | F.Cu | 99.0 | 217.0 | thru_hole | [1.7, 1.7]
J8 | 2 | /12V_Servo | F.Cu | 99.0 | 219.54 | thru_hole | [1.7, 1.7]
J8 | 3 | /PGND | F.Cu | 99.0 | 222.08 | thru_hole | [1.7, 1.7]
R11 | 1 | /VCC | F.Cu | 76.84 | 210.0 | smd | [3.05, 3.68]
R11 | 2 | /Vin | F.Cu | 81.16 | 210.0 | smd | [3.05, 3.68]
C16 | 1 | /DIG_SENSE_P | F.Cu | 84.3 | 213.05 | smd | [1.0, 1.45]
C16 | 2 | /DIG_SENSE_N | F.Cu | 84.3 | 214.95 | smd | [1.0, 1.45]
C19 | 1 | /3V3 | F.Cu | 78.225 | 228.0 | smd | [0.9, 0.95]
C19 | 2 | /GNDA | F.Cu | 79.775 | 228.0 | smd | [0.9, 0.95]
R12 | 1 | /NMOS_DRIVE | F.Cu | 63.0 | 203.825 | smd | [0.8, 0.95]
R12 | 2 | /GATE_Q1 | F.Cu | 63.0 | 202.175 | smd | [0.8, 0.95]
NT3 | 1 | /Vin | F.Cu | 81.5 | 207.0 | smd | [0.5, 0.5]
NT3 | 2 | /SENSE_N | F.Cu | 82.5 | 207.0 | smd | [0.5, 0.5]
R18 | 1 | /3V3 | F.Cu | 78.0 | 219.325 | smd | [0.8, 0.95]
R18 | 2 | /SDA | F.Cu | 78.0 | 217.675 | smd | [0.8, 0.95]
J12 | 1 | /Vin | F.Cu | 83.7 | 193.75 | smd | [6.0, 6.0]
J12 | 2 | /PGND | F.Cu | 90.7 | 193.75 | smd | [6.0, 6.0]
TP3 | 1 | /Voltage | F.Cu | 90.0 | 218.0 | smd | [1.5, 1.5]
R15 | 1 | /SENSE_P | F.Cu | 75.5 | 214.825 | smd | [0.8, 0.95]
R15 | 2 | /DIG_SENSE_P | F.Cu | 75.5 | 213.175 | smd | [0.8, 0.95]
C20 | 1 | /CHARGE_PUMP | F.Cu | 73.8 | 207.75 | smd | [1.0, 1.45]
C20 | 2 | /BAT_FUSED | F.Cu | 73.8 | 205.85 | smd | [1.0, 1.45]
R16 | 1 | /SENSE_N | F.Cu | 75.5 | 218.325 | smd | [0.8, 0.95]
R16 | 2 | /DIG_SENSE_N | F.Cu | 75.5 | 216.675 | smd | [0.8, 0.95]
D3 | 1 | /PGND | F.Cu | 74.0 | 228.9375 | smd | [0.975, 1.4]
D3 | 2 | /LED_A | F.Cu | 74.0 | 227.0625 | smd | [0.975, 1.4]
Q2 |  |  | F.Cu | 67.2 | 206.275 | smd | [0.9, 0.9]
Q2 |  |  | F.Cu | 67.2 | 207.425 | smd | [0.9, 0.9]
Q2 |  |  | F.Cu | 67.2 | 208.575 | smd | [0.9, 0.9]
Q2 |  |  | F.Cu | 67.2 | 209.725 | smd | [0.9, 0.9]
Q2 |  |  | F.Cu | 68.425 | 206.275 | smd | [0.9, 0.9]
Q2 |  |  | F.Cu | 68.425 | 207.425 | smd | [0.9, 0.9]
Q2 |  |  | F.Cu | 68.425 | 208.575 | smd | [0.9, 0.9]
Q2 |  |  | F.Cu | 68.425 | 209.725 | smd | [0.9, 0.9]
Q2 |  |  | F.Cu | 69.625 | 206.275 | smd | [0.9, 0.9]
Q2 |  |  | F.Cu | 69.625 | 207.425 | smd | [0.9, 0.9]
Q2 |  |  | F.Cu | 69.625 | 208.575 | smd | [0.9, 0.9]
Q2 |  |  | F.Cu | 69.625 | 209.725 | smd | [0.9, 0.9]
Q2 | 1 | /GATE_Q2 | F.Cu | 65.175 | 209.905 | smd | [1.2, 0.65]
Q2 | 2 | /VCC | F.Cu | 68.675 | 208.0 | smd | [4.5, 4.7]
Q2 | 2 | /VCC | F.Cu | 70.925 | 206.005 | smd | [1.0, 0.7]
Q2 | 2 | /VCC | F.Cu | 70.925 | 207.335 | smd | [1.0, 0.7]
Q2 | 2 | /VCC | F.Cu | 70.925 | 208.665 | smd | [1.0, 0.7]
Q2 | 2 | /VCC | F.Cu | 70.925 | 209.995 | smd | [1.0, 0.7]
Q2 | 3 | /BAT_FUSED | F.Cu | 65.175 | 206.095 | smd | [1.2, 0.65]
Q2 | 3 | /BAT_FUSED | F.Cu | 65.175 | 207.365 | smd | [1.2, 0.65]
Q2 | 3 | /BAT_FUSED | F.Cu | 65.175 | 207.365 | smd | [1.2, 3.19]
Q2 | 3 | /BAT_FUSED | F.Cu | 65.175 | 208.635 | smd | [1.2, 0.65]
C17 | 1 | /3V3 | F.Cu | 74.725 | 220.0 | smd | [0.9, 0.95]
C17 | 2 | /GNDA | F.Cu | 76.275 | 220.0 | smd | [0.9, 0.95]
J5 | 1 | unconnected-(J5-Pin_1-Pad1) | F.Cu | 84.5 | 221.2 | thru_hole | [1.7, 1.7]
J5 | 2 | /5V_Servo | F.Cu | 84.5 | 223.74 | thru_hole | [1.7, 1.7]
J5 | 3 | /PGND | F.Cu | 84.5 | 226.28 | thru_hole | [1.7, 1.7]
D2 | 1 | /BAT_FUSED | F.Cu | 86.6 | 202.0 | smd | [3.3, 2.5]
D2 | 2 | /PGND | F.Cu | 93.4 | 202.0 | smd | [3.3, 2.5]
C13 | 1 | /Vin | F.Cu | 96.35 | 210.5 | smd | [4.5, 2.1]
C13 | 2 | /PGND | F.Cu | 89.15 | 210.5 | smd | [4.5, 2.1]
NT2 | 1 | /VCC | F.Cu | 78.5 | 207.0 | smd | [0.5, 0.5]
NT2 | 2 | /SENSE_P | F.Cu | 79.5 | 207.0 | smd | [0.5, 0.5]
R14 | 1 | /NMOS_DRIVE | F.Cu | 61.175 | 200.5 | smd | [0.8, 0.95]
R14 | 2 | /BAT_FUSED | F.Cu | 62.825 | 200.5 | smd | [0.8, 0.95]
Q3 |  |  | F.Cu | 67.2 | 213.275 | smd | [0.9, 0.9]
Q3 |  |  | F.Cu | 67.2 | 214.425 | smd | [0.9, 0.9]
Q3 |  |  | F.Cu | 67.2 | 215.575 | smd | [0.9, 0.9]
Q3 |  |  | F.Cu | 67.2 | 216.725 | smd | [0.9, 0.9]
Q3 |  |  | F.Cu | 68.425 | 213.275 | smd | [0.9, 0.9]
Q3 |  |  | F.Cu | 68.425 | 214.425 | smd | [0.9, 0.9]
Q3 |  |  | F.Cu | 68.425 | 215.575 | smd | [0.9, 0.9]
Q3 |  |  | F.Cu | 68.425 | 216.725 | smd | [0.9, 0.9]
Q3 |  |  | F.Cu | 69.625 | 213.275 | smd | [0.9, 0.9]
Q3 |  |  | F.Cu | 69.625 | 214.425 | smd | [0.9, 0.9]
Q3 |  |  | F.Cu | 69.625 | 215.575 | smd | [0.9, 0.9]
Q3 |  |  | F.Cu | 69.625 | 216.725 | smd | [0.9, 0.9]
Q3 | 1 | /GATE_Q3 | F.Cu | 65.175 | 216.905 | smd | [1.2, 0.65]
Q3 | 2 | /VCC | F.Cu | 68.675 | 215.0 | smd | [4.5, 4.7]
Q3 | 2 | /VCC | F.Cu | 70.925 | 213.005 | smd | [1.0, 0.7]
Q3 | 2 | /VCC | F.Cu | 70.925 | 214.335 | smd | [1.0, 0.7]
Q3 | 2 | /VCC | F.Cu | 70.925 | 215.665 | smd | [1.0, 0.7]
Q3 | 2 | /VCC | F.Cu | 70.925 | 216.995 | smd | [1.0, 0.7]
Q3 | 3 | /BAT_FUSED | F.Cu | 65.175 | 213.095 | smd | [1.2, 0.65]
Q3 | 3 | /BAT_FUSED | F.Cu | 65.175 | 214.365 | smd | [1.2, 0.65]
Q3 | 3 | /BAT_FUSED | F.Cu | 65.175 | 214.365 | smd | [1.2, 3.19]
Q3 | 3 | /BAT_FUSED | F.Cu | 65.175 | 215.635 | smd | [1.2, 0.65]
C14 | 1 | /out | F.Cu | 82.0 | 223.275 | smd | [0.9, 0.95]
C14 | 2 | /GNDA | F.Cu | 82.0 | 221.725 | smd | [0.9, 0.95]
R17 | 1 | /3V3 | F.Cu | 73.5 | 218.325 | smd | [0.8, 0.95]
R17 | 2 | /SCL | F.Cu | 73.5 | 216.675 | smd | [0.8, 0.95]
U2 | 1 | /Current | F.Cu | 74.05 | 224.1375 | smd | [1.325, 0.6]
U2 | 2 | /GNDA | F.Cu | 75.0 | 224.1375 | smd | [1.325, 0.6]
U2 | 3 | /SENSE_P | F.Cu | 75.95 | 224.1375 | smd | [1.325, 0.6]
U2 | 4 | /SENSE_N | F.Cu | 75.95 | 221.8625 | smd | [1.325, 0.6]
U2 | 5 | /out | F.Cu | 74.05 | 221.8625 | smd | [1.325, 0.6]
Q4 |  |  | F.Cu | 68.1 | 220.275 | smd | [0.9, 0.9]
Q4 |  |  | F.Cu | 68.1 | 221.425 | smd | [0.9, 0.9]
Q4 |  |  | F.Cu | 68.1 | 222.575 | smd | [0.9, 0.9]
Q4 |  |  | F.Cu | 68.1 | 223.725 | smd | [0.9, 0.9]
Q4 |  |  | F.Cu | 69.325 | 220.275 | smd | [0.9, 0.9]
Q4 |  |  | F.Cu | 69.325 | 221.425 | smd | [0.9, 0.9]
Q4 |  |  | F.Cu | 69.325 | 222.575 | smd | [0.9, 0.9]
Q4 |  |  | F.Cu | 69.325 | 223.725 | smd | [0.9, 0.9]
Q4 |  |  | F.Cu | 70.525 | 220.275 | smd | [0.9, 0.9]
Q4 |  |  | F.Cu | 70.525 | 221.425 | smd | [0.9, 0.9]
Q4 |  |  | F.Cu | 70.525 | 222.575 | smd | [0.9, 0.9]
Q4 |  |  | F.Cu | 70.525 | 223.725 | smd | [0.9, 0.9]
Q4 | 1 | /GATE_Q4 | F.Cu | 66.075 | 223.905 | smd | [1.2, 0.65]
Q4 | 2 | /VCC | F.Cu | 69.575 | 222.0 | smd | [4.5, 4.7]
Q4 | 2 | /VCC | F.Cu | 71.825 | 220.005 | smd | [1.0, 0.7]
Q4 | 2 | /VCC | F.Cu | 71.825 | 221.335 | smd | [1.0, 0.7]
Q4 | 2 | /VCC | F.Cu | 71.825 | 222.665 | smd | [1.0, 0.7]
Q4 | 2 | /VCC | F.Cu | 71.825 | 223.995 | smd | [1.0, 0.7]
Q4 | 3 | /BAT_FUSED | F.Cu | 66.075 | 220.095 | smd | [1.2, 0.65]
Q4 | 3 | /BAT_FUSED | F.Cu | 66.075 | 221.365 | smd | [1.2, 0.65]
Q4 | 3 | /BAT_FUSED | F.Cu | 66.075 | 221.365 | smd | [1.2, 3.19]
Q4 | 3 | /BAT_FUSED | F.Cu | 66.075 | 222.635 | smd | [1.2, 0.65]
R8 | 1 | /Vin | F.Cu | 92.5375 | 217.0 | smd | [1.125, 1.75]
R8 | 2 | /Voltage | F.Cu | 95.4625 | 217.0 | smd | [1.125, 1.75]
R21 | 1 | /NMOS_DRIVE | F.Cu | 64.0 | 222.325 | smd | [0.8, 0.95]
R21 | 2 | /GATE_Q4 | F.Cu | 64.0 | 220.675 | smd | [0.8, 0.95]
U1 |  |  | B.Cu | 86.25 | 212.0 | smd | [1.15, 1.05]
U1 |  |  | B.Cu | 86.25 | 210.6 | smd | [1.15, 1.05]
U1 |  |  | B.Cu | 86.25 | 209.2 | smd | [1.15, 1.05]
U1 |  |  | B.Cu | 84.75 | 212.0 | smd | [1.15, 1.05]
U1 |  |  | B.Cu | 84.75 | 210.6 | smd | [1.15, 1.05]
U1 |  |  | B.Cu | 84.75 | 209.2 | smd | [1.15, 1.05]
U1 | 1 | /BUCK_BIAS | B.Cu | 88.47 | 207.68 | smd | [1.78, 0.42]
U1 | 2 | /SD | B.Cu | 88.47 | 208.33 | smd | [1.78, 0.42]
U1 | 3 | /Vin | B.Cu | 88.47 | 208.98 | smd | [1.78, 0.42]
U1 | 4 | /Vin | B.Cu | 88.47 | 209.63 | smd | [1.78, 0.42]
U1 | 5 | unconnected-(U1-SYNC-Pad5) | B.Cu | 88.47 | 210.27 | smd | [1.78, 0.42]
U1 | 6 | /COMP | B.Cu | 88.47 | 210.93 | smd | [1.78, 0.42]
U1 | 7 | /FB | B.Cu | 88.47 | 211.57 | smd | [1.78, 0.42]
U1 | 8 | /RT | B.Cu | 88.47 | 212.22 | smd | [1.78, 0.42]
U1 | 9 | /RAMP | B.Cu | 88.47 | 212.87 | smd | [1.78, 0.42]
U1 | 10 | /GNDA | B.Cu | 88.47 | 213.52 | smd | [1.78, 0.42]
U1 | 11 | /SS | B.Cu | 82.53 | 213.52 | smd | [1.78, 0.42]
U1 | 12 | /out | B.Cu | 82.53 | 212.87 | smd | [1.78, 0.42]
U1 | 13 | /PGND | B.Cu | 82.53 | 212.22 | smd | [1.78, 0.42]
U1 | 14 | /PGND | B.Cu | 82.53 | 211.57 | smd | [1.78, 0.42]
U1 | 15 | /IS_RETURN | B.Cu | 82.53 | 210.93 | smd | [1.78, 0.42]
U1 | 16 | /IS_RETURN | B.Cu | 82.53 | 210.27 | smd | [1.78, 0.42]
U1 | 17 | /SW | B.Cu | 82.53 | 209.63 | smd | [1.78, 0.42]
U1 | 18 | /SW | B.Cu | 82.53 | 208.98 | smd | [1.78, 0.42]
U1 | 19 | /SW | B.Cu | 82.53 | 208.33 | smd | [1.78, 0.42]
U1 | 20 | /BST | B.Cu | 82.53 | 207.68 | smd | [1.78, 0.42]
U1 | 21 | /PGND | B.Cu | 85.5 | 210.6 | smd | [3.0, 4.2]
J3 | 1 | /Vin | B.Cu | 82.0 | 192.5 | smd | [2.5, 3.0]
J3 | 2 | /PGND | B.Cu | 85.5 | 192.5 | smd | [2.5, 3.0]
J3 | 3 | /5V_Servo | B.Cu | 89.0 | 192.5 | smd | [2.5, 3.0]
J3 | 4 | /PGND | B.Cu | 92.5 | 192.5 | smd | [2.5, 3.0]
C3 | 1 | /GNDA | B.Cu | 95.275 | 215.5 | smd | [0.9, 0.95]
C3 | 2 | /RAMP | B.Cu | 93.725 | 215.5 | smd | [0.9, 0.95]
R7 | 1 | /COMP | B.Cu | 90.425 | 211.0 | smd | [0.8, 0.95]
R7 | 2 | /COMP_RC | B.Cu | 92.075 | 211.0 | smd | [0.8, 0.95]
J4 | 1 | /Vin | B.Cu | 63.0 | 211.85 | smd | [3.0, 4.0]
J4 | 2 | /PGND | B.Cu | 63.0 | 207.85 | smd | [3.0, 4.0]
J4 | 3 | /12V_Servo | B.Cu | 63.0 | 203.85 | smd | [3.0, 4.0]
J4 | 4 | /PGND | B.Cu | 63.0 | 199.85 | smd | [3.0, 4.0]
C2 | 1 | /PGND | B.Cu | 84.45 | 198.5 | smd | [1.4, 3.4]
C2 | 2 | /Vin | B.Cu | 88.55 | 198.5 | smd | [1.4, 3.4]
C5 | 1 | /PGND | B.Cu | 92.025 | 207.75 | smd | [0.9, 0.95]
C5 | 2 | /BUCK_BIAS | B.Cu | 90.475 | 207.75 | smd | [0.9, 0.95]
R5 | 1 | /out | B.Cu | 98.575 | 213.75 | smd | [0.8, 0.95]
R5 | 2 | /FB | B.Cu | 96.925 | 213.75 | smd | [0.8, 0.95]
J10 | 1 | /Vin | B.Cu | 98.0 | 211.0 | smd | [3.0, 4.0]
J10 | 2 | /PGND | B.Cu | 98.0 | 207.0 | smd | [3.0, 4.0]
J10 | 3 | /12V_DJI | B.Cu | 98.0 | 203.0 | smd | [3.0, 4.0]
J10 | 4 | /PGND | B.Cu | 98.0 | 199.0 | smd | [3.0, 4.0]
C11 | 1 | /COMP | B.Cu | 90.475 | 212.75 | smd | [0.9, 0.95]
C11 | 2 | /FB | B.Cu | 92.025 | 212.75 | smd | [0.9, 0.95]
D1 |  |  | B.Cu | 73.46 | 200.72 | smd | [2.2, 1.2]
D1 |  |  | B.Cu | 78.085 | 201.475 | smd | [3.05, 2.75]
D1 |  |  | B.Cu | 78.085 | 204.525 | smd | [3.05, 2.75]
D1 |  |  | B.Cu | 81.435 | 201.475 | smd | [3.05, 2.75]
D1 |  |  | B.Cu | 81.435 | 204.525 | smd | [3.05, 2.75]
D1 | 1 | /SW | B.Cu | 79.76 | 203.0 | smd | [6.4, 5.8]
D1 | 2 | /IS_RETURN | B.Cu | 73.46 | 205.28 | smd | [2.2, 1.2]
L1 | 1 | /out | B.Cu | 72.67 | 215.0 | smd | [1.78, 7.0]
L1 | 2 | /SW | B.Cu | 77.83 | 215.0 | smd | [1.78, 7.0]
NT1 | 1 | /GNDA | B.Cu | 87.3 | 215.0 | smd | [0.5, 0.5]
NT1 | 2 | /PGND | B.Cu | 86.3 | 215.0 | smd | [0.5, 0.5]
C8 | 1 | /SW | B.Cu | 80.55 | 198.25 | smd | [1.0, 1.45]
C8 | 2 | /SNUB | B.Cu | 82.45 | 198.25 | smd | [1.0, 1.45]
C12 | 1 | /COMP_RC | B.Cu | 93.75 | 211.775 | smd | [0.9, 0.95]
C12 | 2 | /FB | B.Cu | 93.75 | 210.225 | smd | [0.9, 0.95]
C9 | 1 | /out | B.Cu | 68.8 | 217.375 | smd | [3.5, 1.6]
C9 | 2 | /PGND | B.Cu | 63.2 | 217.375 | smd | [3.5, 1.6]
J2 | 1 | /out | B.Cu | 70.0 | 223.05 | smd | [1.0, 2.9]
J2 | 2 | /out | B.Cu | 72.0 | 223.05 | smd | [1.0, 2.9]
J2 | 3 | /SCL | B.Cu | 74.0 | 223.05 | smd | [1.0, 2.9]
J2 | 4 | /SDA | B.Cu | 76.0 | 223.05 | smd | [1.0, 2.9]
J2 | 5 | /PGND | B.Cu | 78.0 | 223.05 | smd | [1.0, 2.9]
J2 | 6 | /PGND | B.Cu | 80.0 | 223.05 | smd | [1.0, 2.9]
J2 | MP |  | B.Cu | 67.65 | 227.7 | smd | [1.8, 3.6]
J2 | MP |  | B.Cu | 82.35 | 227.7 | smd | [1.8, 3.6]
R1 | 1 | /Vin | B.Cu | 90.175 | 200.5 | smd | [0.8, 0.95]
R1 | 2 | /SD | B.Cu | 91.825 | 200.5 | smd | [0.8, 0.95]
BEC1 | 1 | /Vin | B.Cu | 67.5 | 192.5 | smd | [2.5, 3.0]
BEC1 | 2 | /PGND | B.Cu | 71.0 | 192.5 | smd | [2.5, 3.0]
BEC1 | 3 | /5V_PI | B.Cu | 74.5 | 192.5 | smd | [2.5, 3.0]
BEC1 | 4 | /PGND | B.Cu | 78.0 | 192.5 | smd | [2.5, 3.0]
C4 | 1 | /GNDA | B.Cu | 93.525 | 204.5 | smd | [0.9, 0.95]
C4 | 2 | /SD | B.Cu | 91.975 | 204.5 | smd | [0.9, 0.95]
C7 | 1 | /SW | B.Cu | 78.55 | 208.0 | smd | [1.0, 1.45]
C7 | 2 | /BST | B.Cu | 80.45 | 208.0 | smd | [1.0, 1.45]
C1 | 1 | /PGND | B.Cu | 85.95 | 203.75 | smd | [1.4, 3.4]
C1 | 2 | /Vin | B.Cu | 90.05 | 203.75 | smd | [1.4, 3.4]
R4 | 1 | /GNDA | B.Cu | 92.075 | 214.5 | smd | [0.8, 0.95]
R4 | 2 | /RT | B.Cu | 90.425 | 214.5 | smd | [0.8, 0.95]
C10 | 1 | /out | B.Cu | 81.0 | 219.975 | smd | [1.15, 1.8]
C10 | 2 | /PGND | B.Cu | 81.0 | 217.025 | smd | [1.15, 1.8]
R6 | 1 | /FB | B.Cu | 95.325 | 213.75 | smd | [0.8, 0.95]
R6 | 2 | /GNDA | B.Cu | 93.675 | 213.75 | smd | [0.8, 0.95]
J11 | 1 | /12V_DJI | B.Cu | 96.4 | 218.4 | smd | [3.0, 3.0]
J11 | 2 | /PGND | B.Cu | 92.4 | 218.4 | smd | [3.0, 3.0]
R2 | 1 | /GNDA | B.Cu | 93.5 | 202.825 | smd | [0.8, 0.95]
R2 | 2 | /SD | B.Cu | 93.5 | 201.175 | smd | [0.8, 0.95]
C6 | 1 | /GNDA | B.Cu | 82.225 | 215.25 | smd | [0.9, 0.95]
C6 | 2 | /SS | B.Cu | 83.775 | 215.25 | smd | [0.9, 0.95]
