scarletnova20/Power_Distribution_Board/engineering/release50/lioncircuits_review/previews/component_locator_back.png

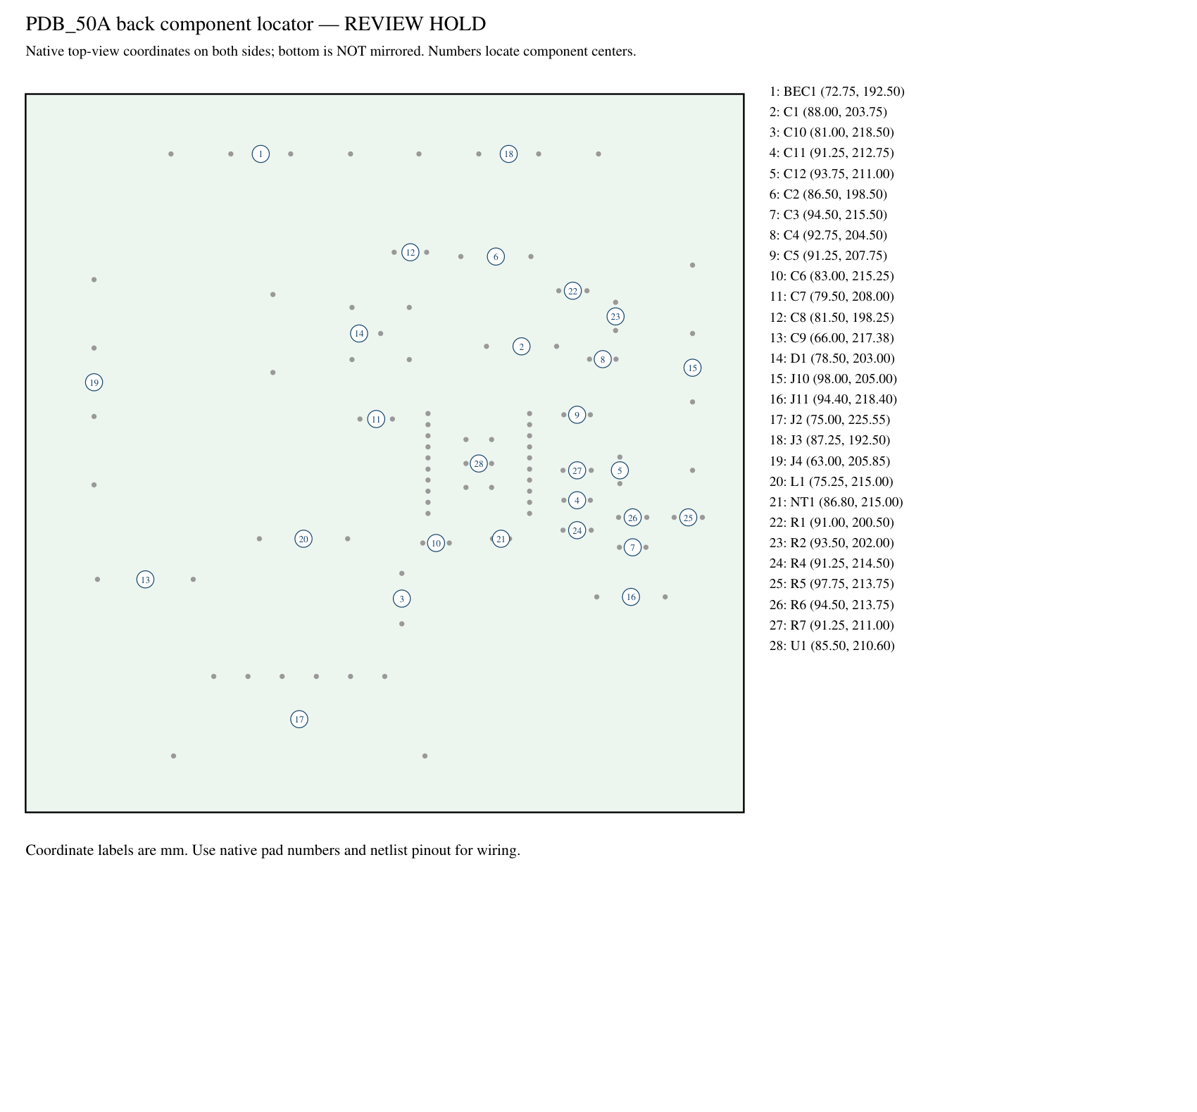
engineering/release50/lioncircuits_review/previews/component_locator_back.png
