scarletnova20/Power_Distribution_Board/engineering/release50/lioncircuits_review/previews/assembly_back.png

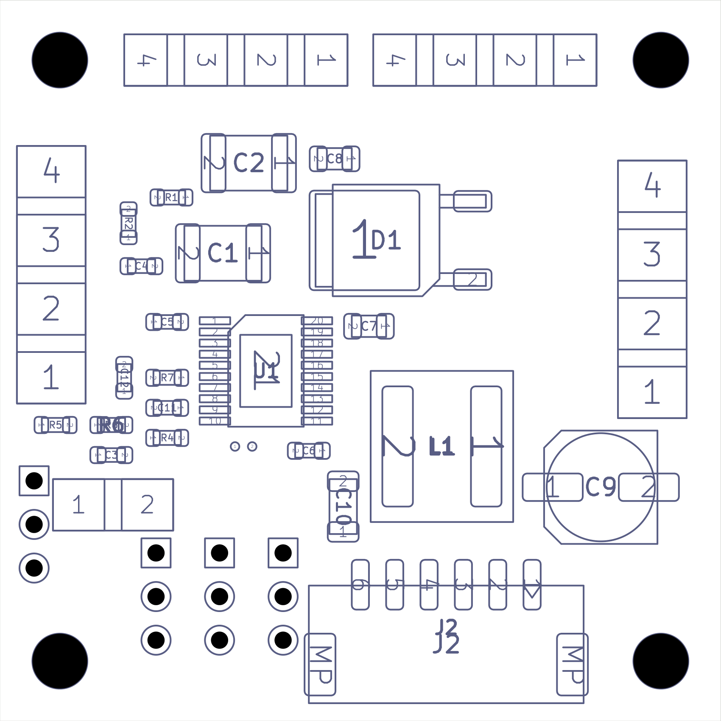
engineering/release50/lioncircuits_review/previews/assembly_back.png
