scarletnova20/Power_Distribution_Board/(list of files, drawings)

Other design files:
engineering/pcb_sync_audit.json
engineering/placed.dsn
engineering/release42/candidate.dsn
engineering/release42/placed.dsn
