scarletnova20/Power_Distribution_Board/engineering/release50/before_fabrication/PDB_50A.kicad_pcb

## KiCad design engineering/release50/before_fabrication/PDB_50A.kicad_pcb (2026-10-10)

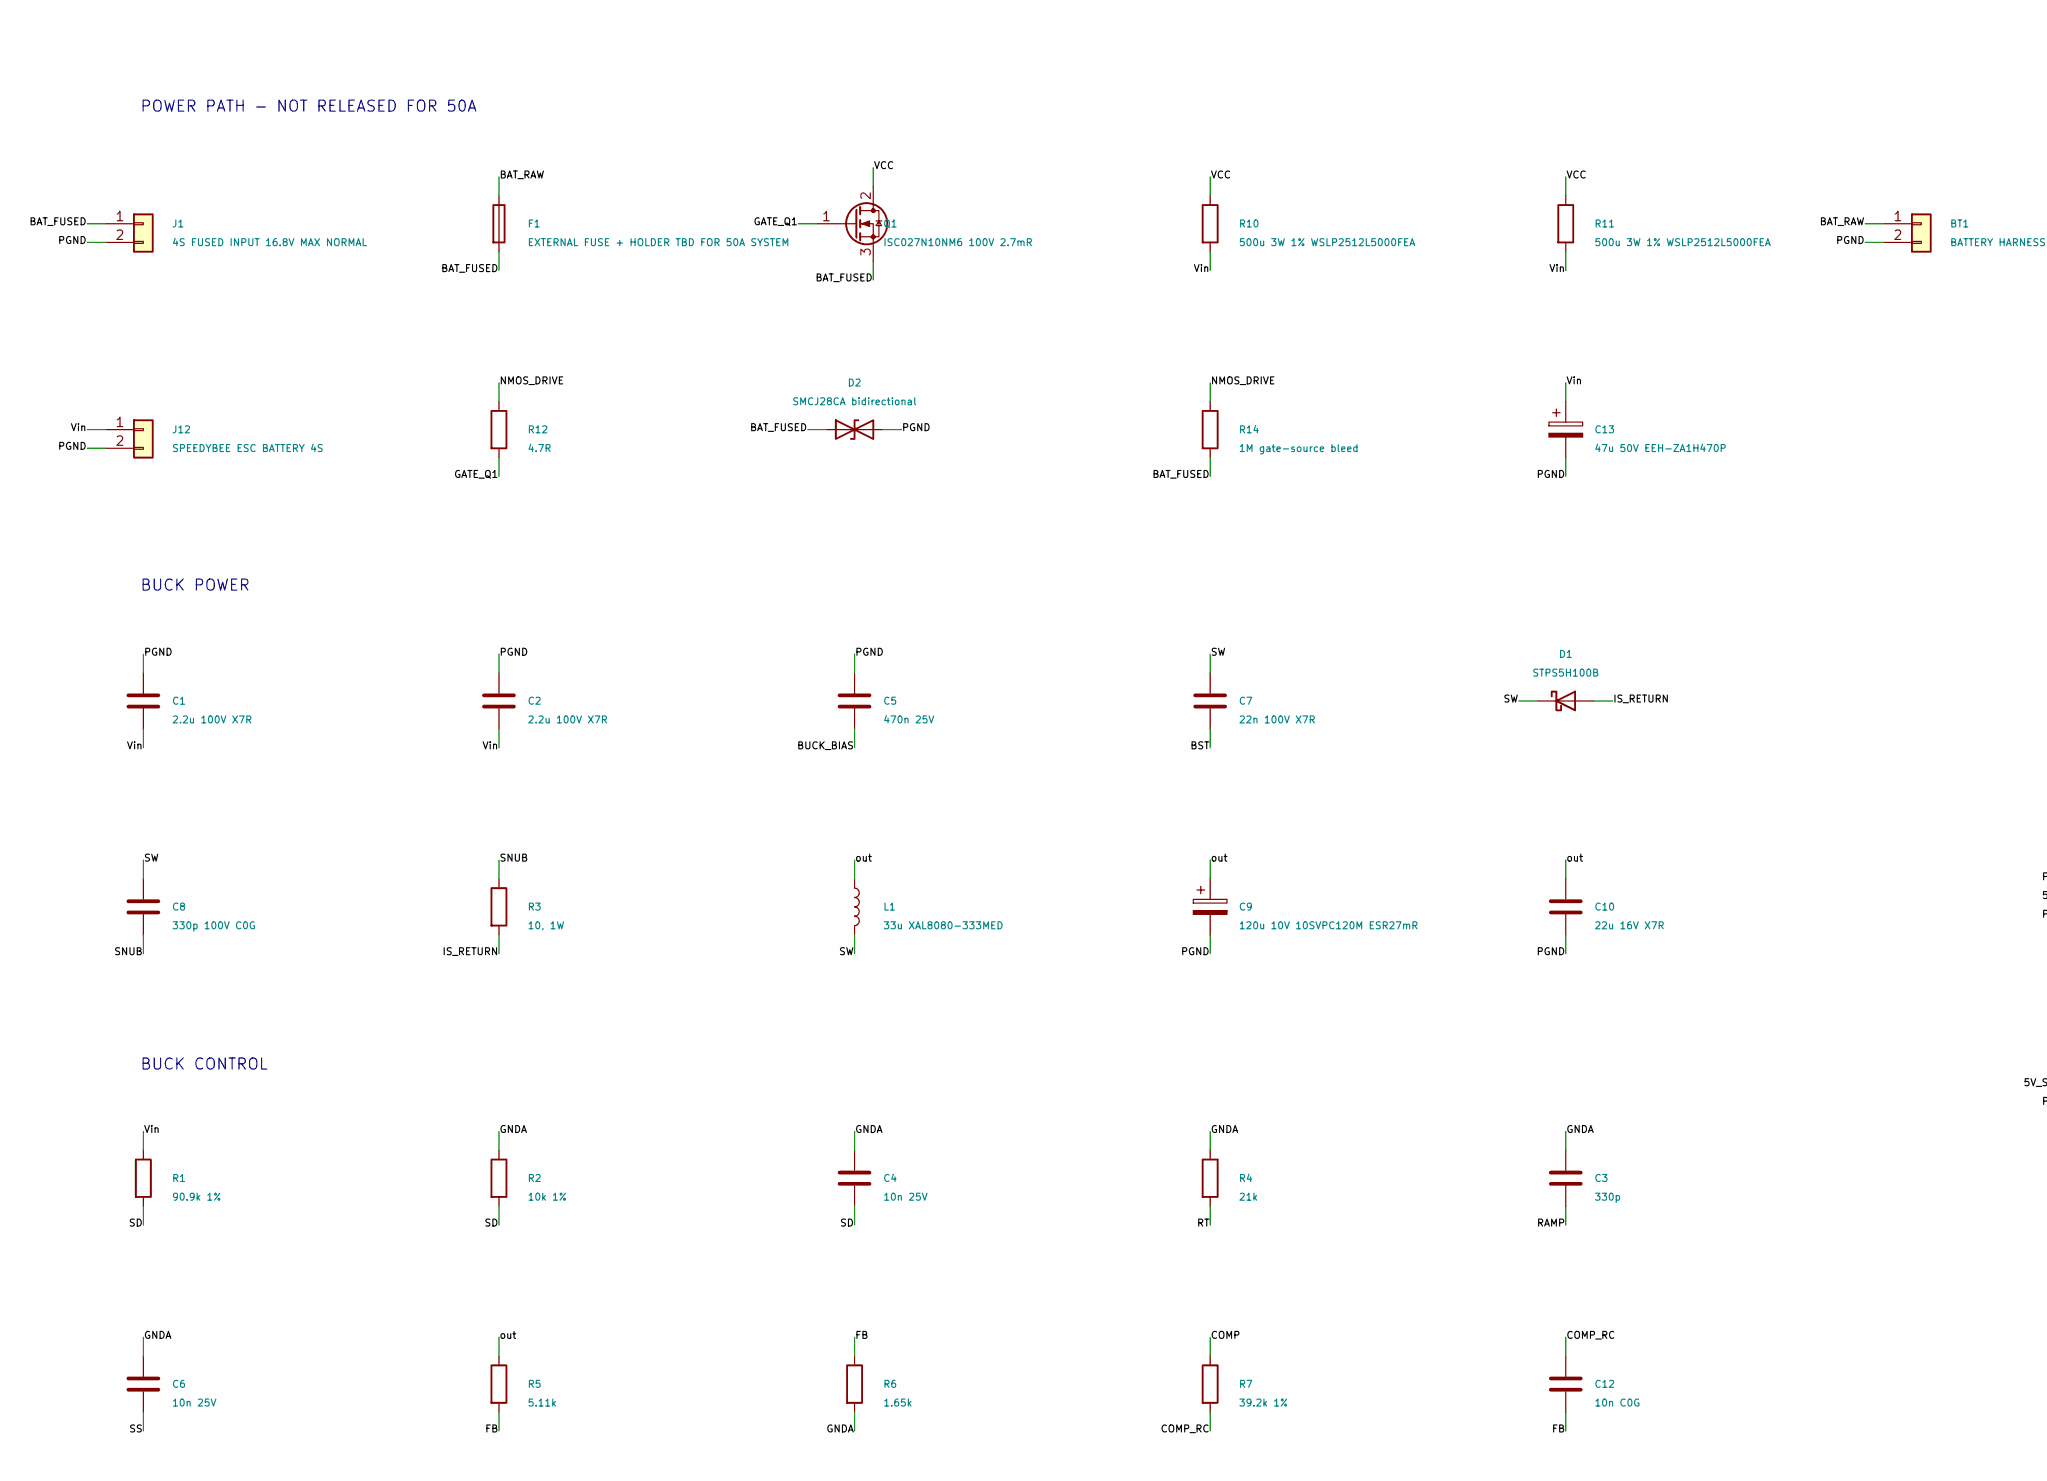
[picture p38: schematic PDB_50A.kicad_sch, Swayatt_PCB - electrical corrections / RELEASE HOLD, part in row 1, column 1]

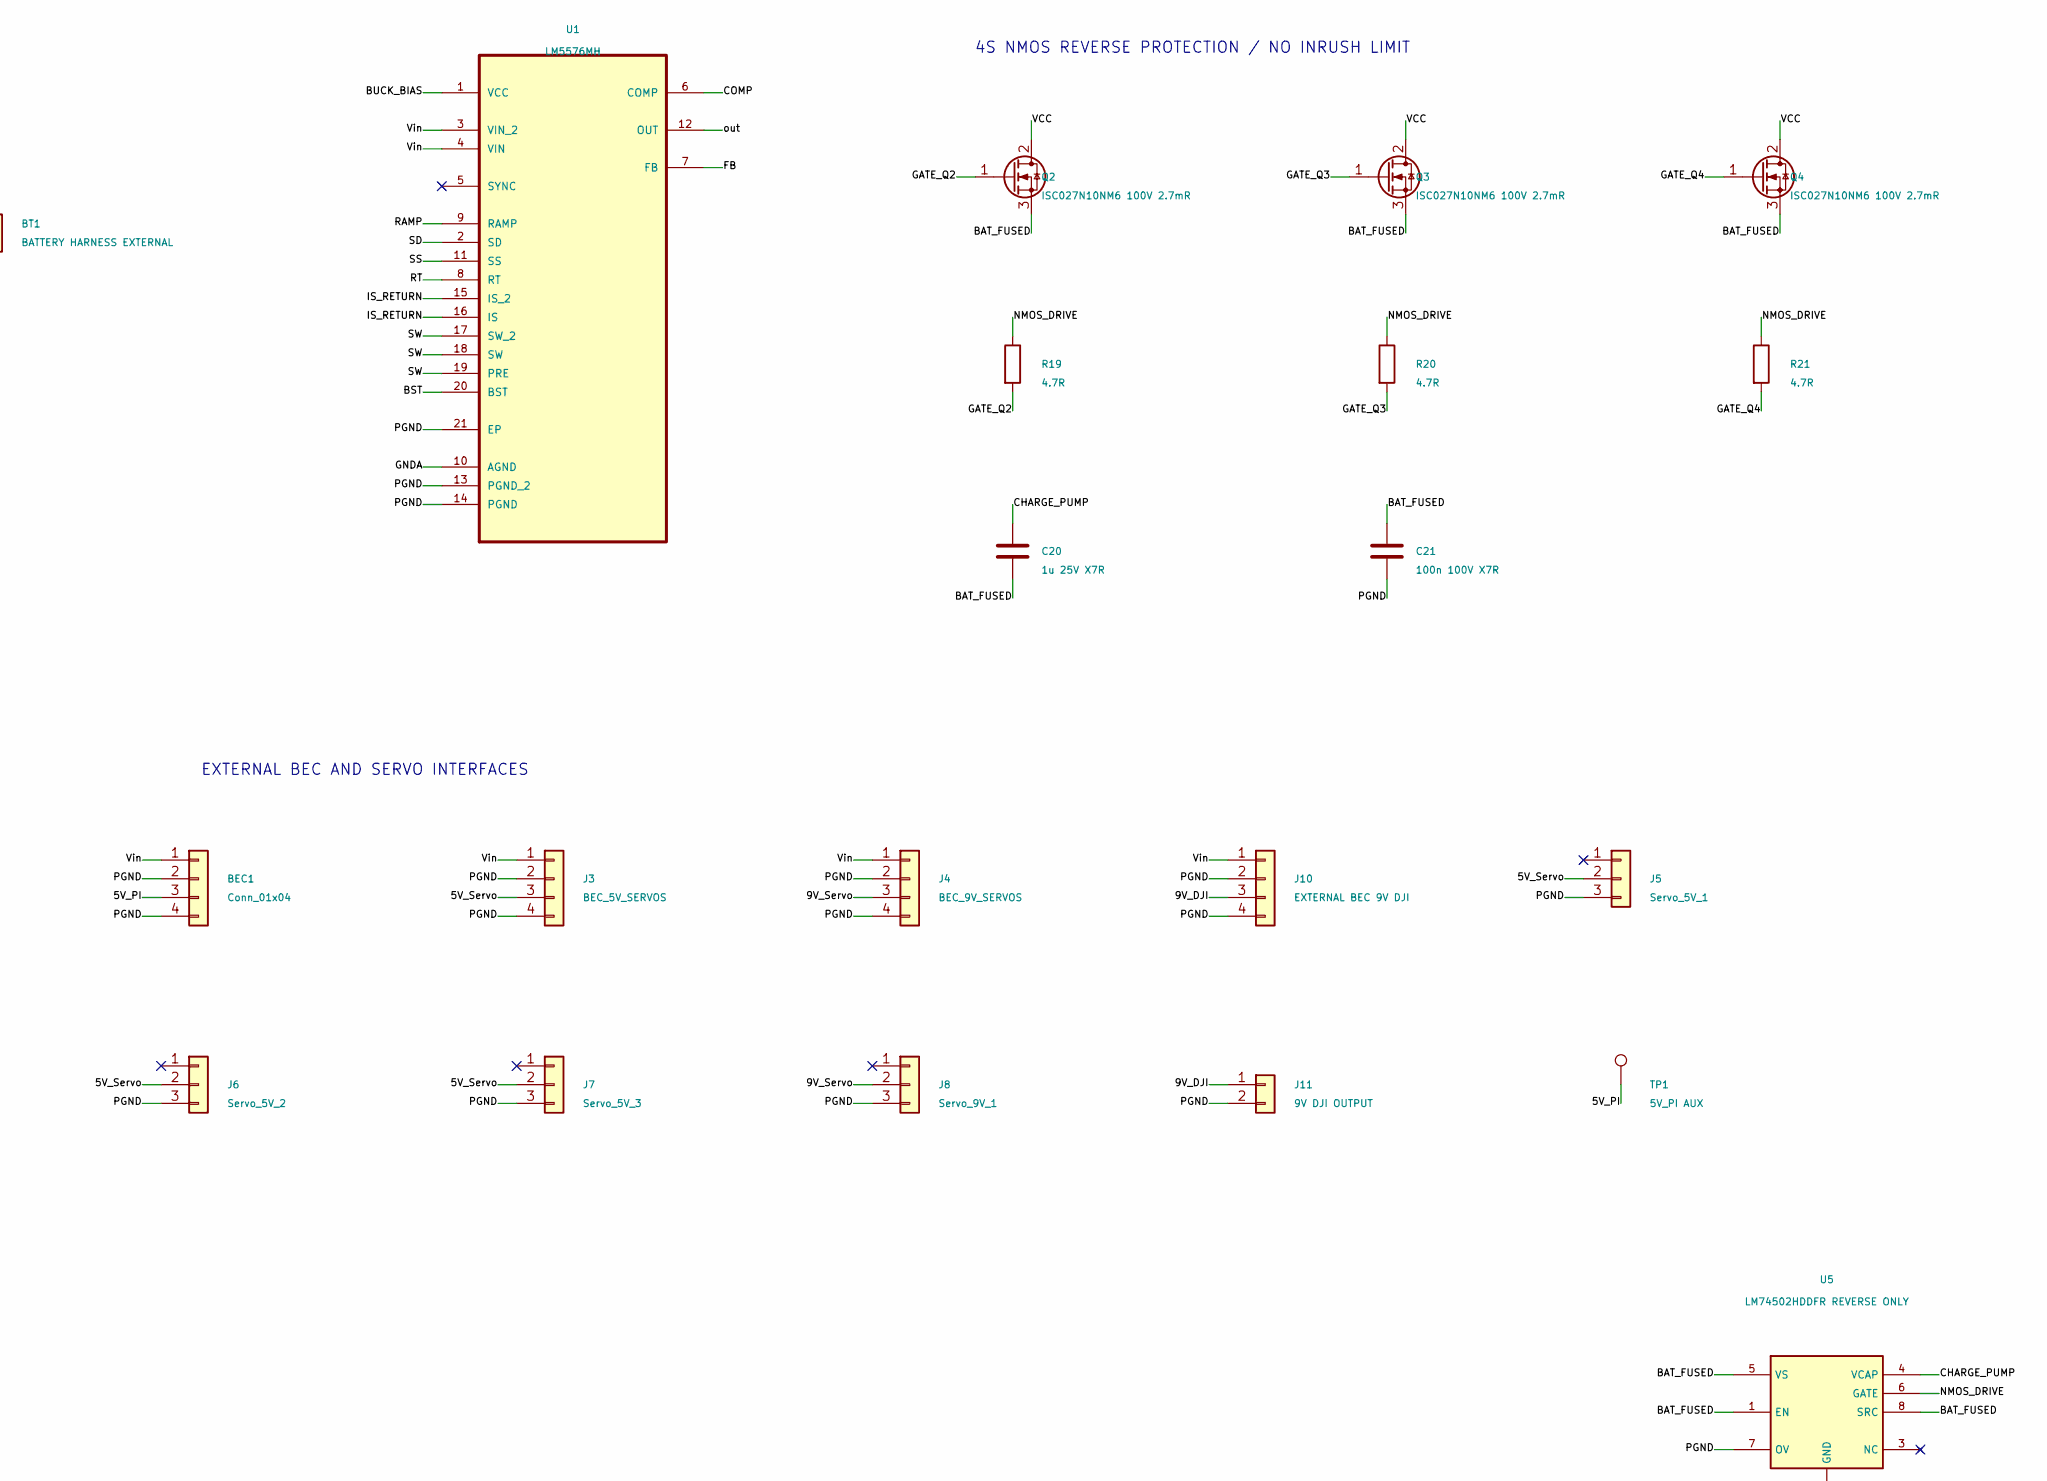
[picture p39: schematic PDB_50A.kicad_sch, Swayatt_PCB - electrical corrections / RELEASE HOLD, part in row 1, column 2]

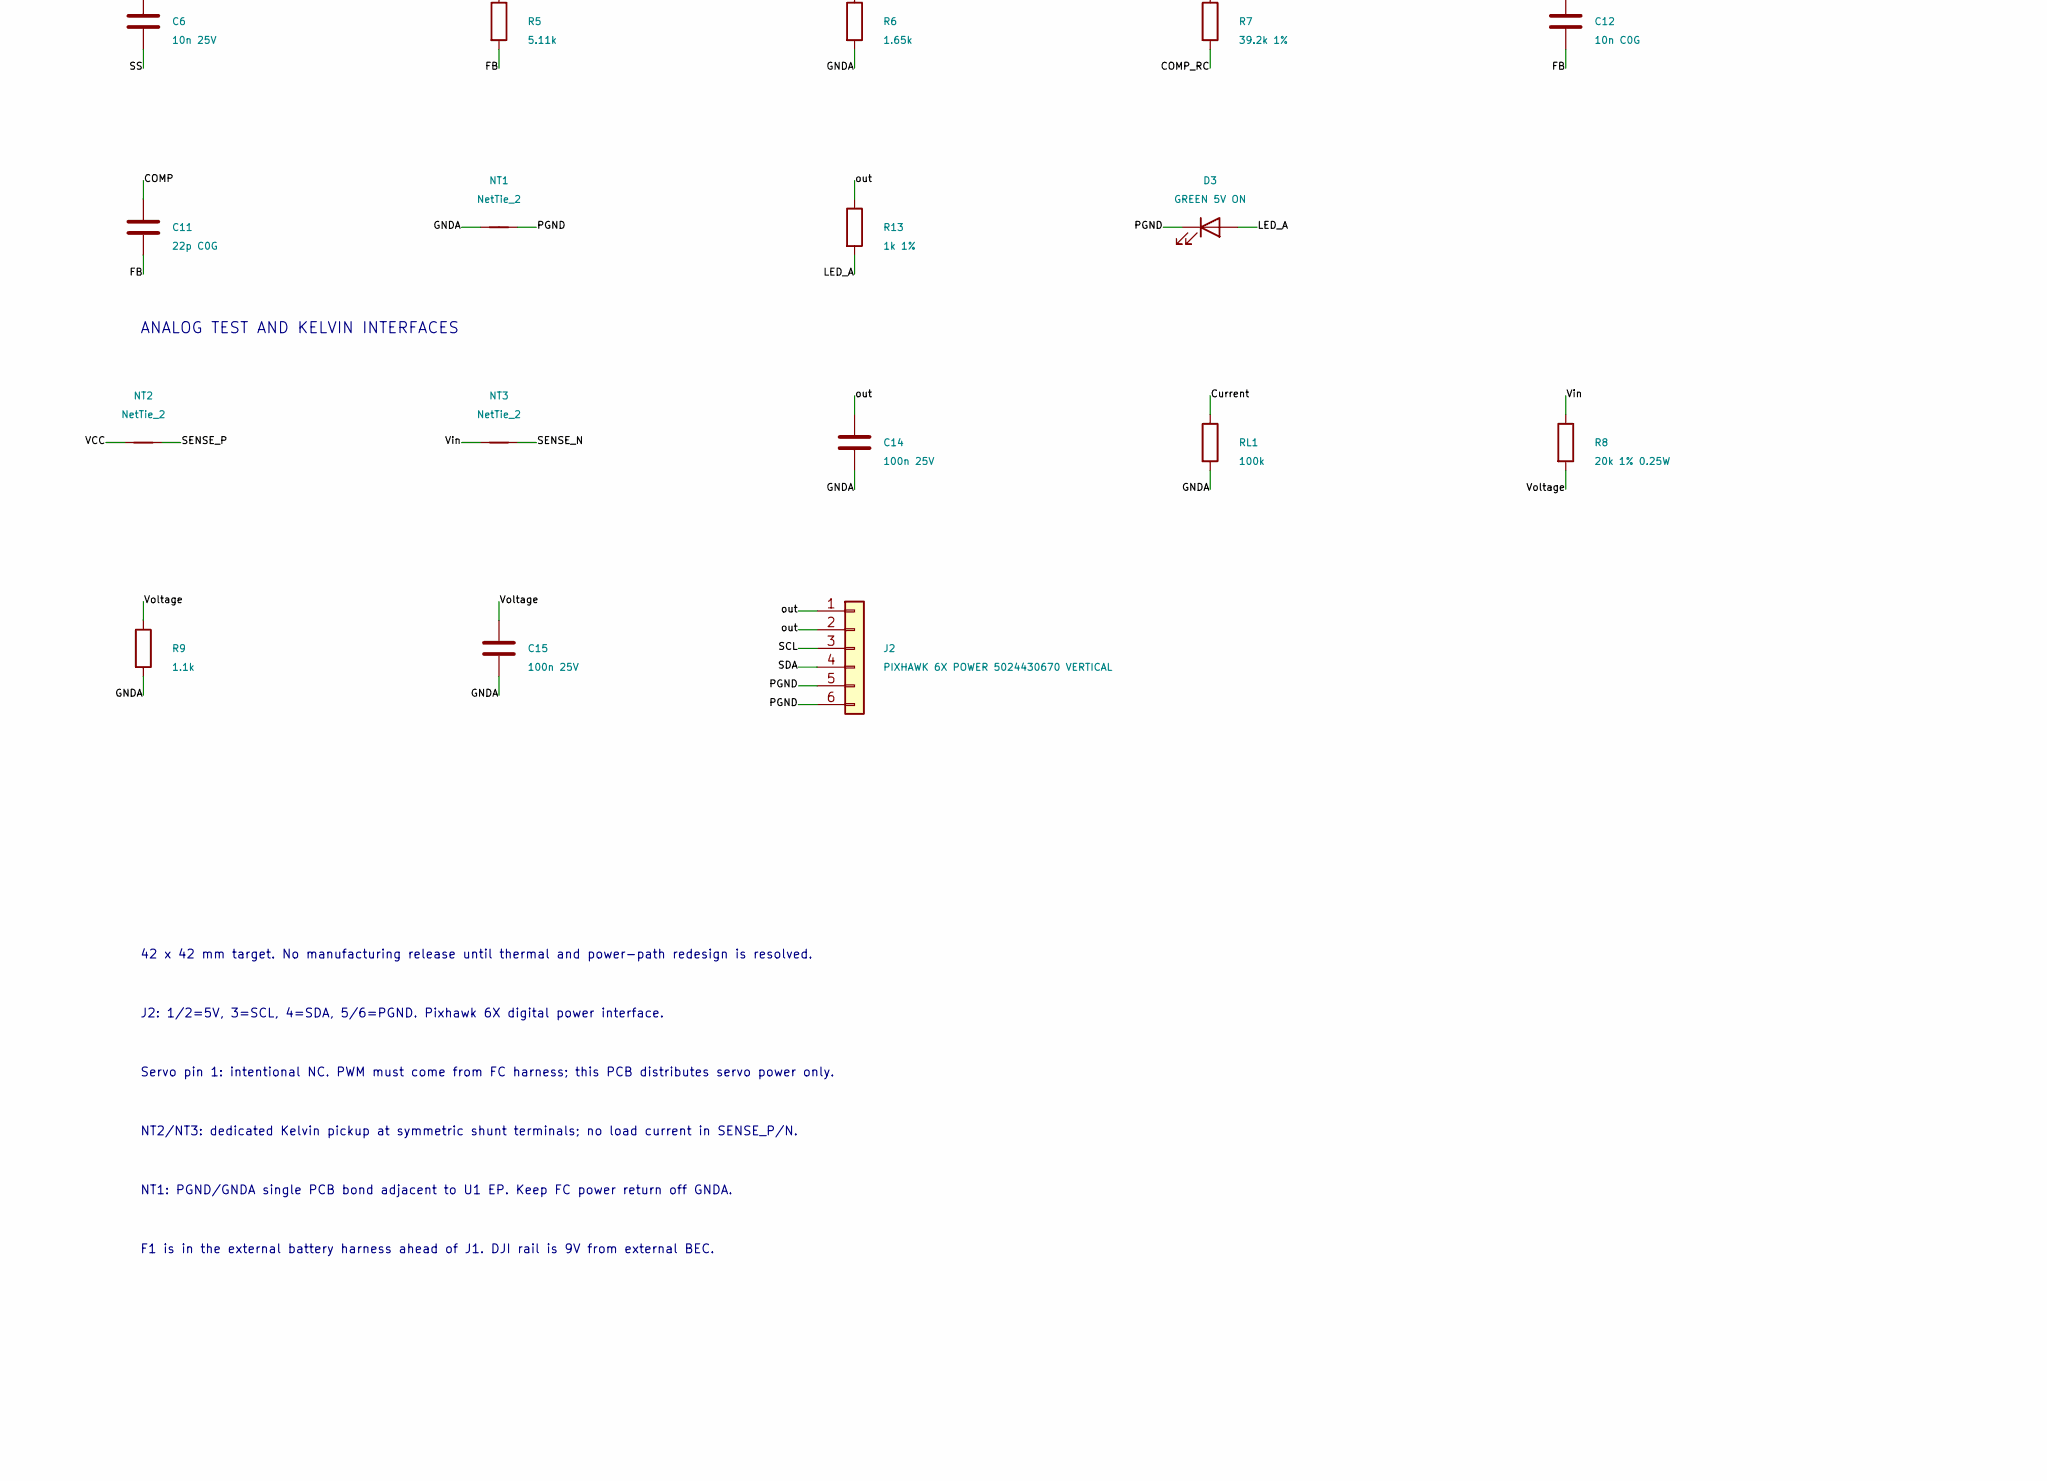
[picture p40: schematic PDB_50A.kicad_sch, Swayatt_PCB - electrical corrections / RELEASE HOLD, part in row 2, column 1]

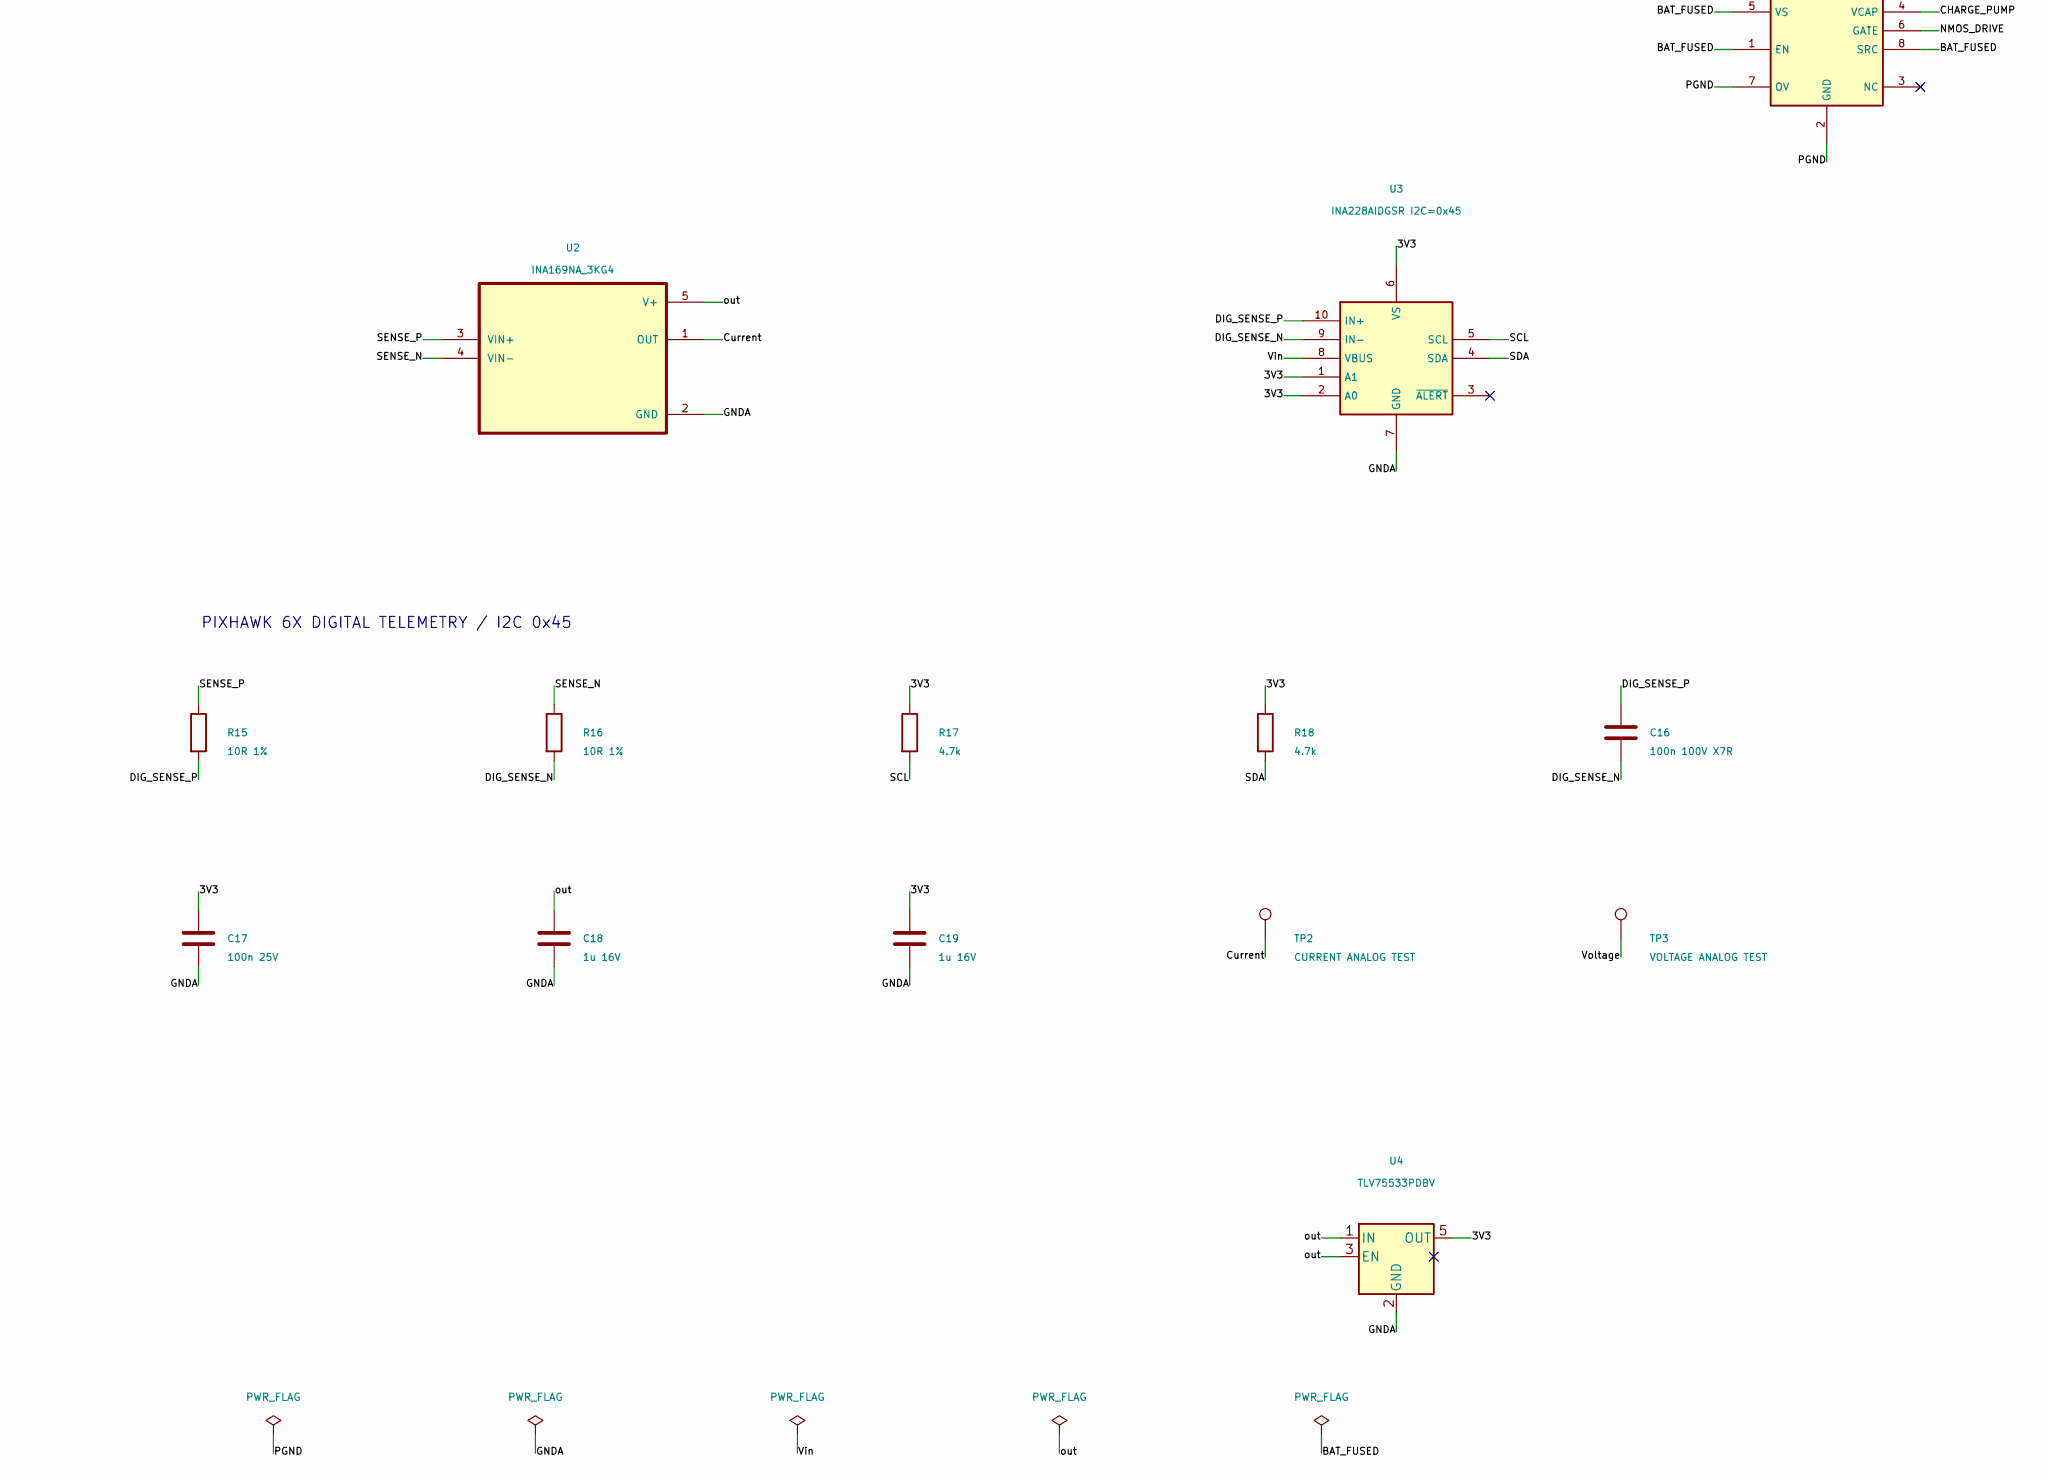
[picture p41: schematic PDB_50A.kicad_sch, Swayatt_PCB - electrical corrections / RELEASE HOLD, part in row 2, column 2]

Parts:
BEC1: Conn_01x04; BEC_Wire_4_42
BT1: BATTERY HARNESS EXTERNAL
C1, C2: 2.2u 100V X7R; C_1812_4532Metric
C3: 330p; C_0603_1608Metric
C4, C6: 10n 25V; C_0603_1608Metric
C5: 470n 25V; C_0603_1608Metric
C7: 22n 100V X7R; C_0805_2012Metric
C8: 330p 100V C0G; C_0805_2012Metric
C9: 120u 10V 10SVPC120M ESR27mR; Panasonic_OSCON_C6_10SVPC120M
C10: 22u 16V X7R; C_1206_3216Metric
C11: 22p C0G; C_0603_1608Metric
C12: 10n C0G; C_0603_1608Metric
C13: 47u 50V EEH-ZA1H470P; C_Elec_8x10.2
C14, C15, C17: 100n 25V; C_0603_1608Metric
C16, C21: 100n 100V X7R; C_0805_2012Metric
C18, C19: 1u 16V; C_0603_1608Metric
C20: 1u 25V X7R; C_0805_2012Metric
D1: STPS5H100B
D2: SMCJ28CA bidirectional; D_SMC
D3: GREEN 5V ON; LED_0805_2012Metric
F1: EXTERNAL FUSE + HOLDER TBD FOR 50A SYSTEM
J1: 4S FUSED INPUT 16.8V MAX NORMAL; Power_Wire_2_42
J2: PIXHAWK 6X POWER 5024430670 VERTICAL; CLIK_Mate_502443_0670
J3: BEC_5V_SERVOS; BEC_Wire_4_42
J4: BEC_9V_SERVOS; BEC_Wire_4
J5: Servo_5V_1; PinHeader_1x03_P2.54mm_Vertical
J6: Servo_5V_2; PinHeader_1x03_P2.54mm_Vertical
J7: Servo_5V_3; PinHeader_1x03_P2.54mm_Vertical
J8: Servo_9V_1; PinHeader_1x03_P2.54mm_Vertical
J10: EXTERNAL BEC 9V DJI; BEC_Wire_4
J11: 9V DJI OUTPUT; Aux_Wire_2_42
J12: SPEEDYBEE ESC BATTERY 4S; Power_Wire_2_42
L1: 33u XAL8080-333MED; L_Coilcraft_XAL8080-XXX
NT1, NT2, NT3: NetTie_2; NetTie-2_SMD_Pad0.5mm
Q1, Q2, Q3, Q4: ISC027N10NM6 100V 2.7mR; ISC027N10NM6_GDS
R1: 90.9k 1%; R_0603_1608Metric
R2: 10k 1%; R_0603_1608Metric
R3: 10, 1W; R_2512_6332Metric
R4: 21k; R_0603_1608Metric
R5: 5.11k; R_0603_1608Metric
R6: 1.65k; R_0603_1608Metric
R7: 39.2k 1%; R_0603_1608Metric
R8: 20k 1% 0.25W; R_1206_3216Metric
R9: 1.1k; R_0603_1608Metric
R10, R11: 500u 3W 1% WSLP2512L5000FEA; WSLP2512_L5000
R12, R19, R20, R21: 4.7R; R_0603_1608Metric
R13: 1k 1%; R_0603_1608Metric
R14: 1M gate-source bleed; R_0603_1608Metric
R15, R16: 10R 1%; R_0603_1608Metric
R17, R18: 4.7k; R_0603_1608Metric
RL1: 100k; R_0603_1608Metric
TP1: 5V_PI AUX; TestPoint_Pad_D1.5mm
TP2: CURRENT ANALOG TEST; TestPoint_Pad_D1.5mm
TP3: VOLTAGE ANALOG TEST; TestPoint_Pad_D1.5mm
U1: LM5576MH; LM5576_PWP20; MPN LM5576MH
U2: INA169NA_3KG4; SOT-23-5
U3: INA228AIDGSR I2C=0x45; INA228_DGS0010A
U4: TLV75533PDBV; SOT-23-5
U5: LM74502HDDFR REVERSE ONLY; LM74502_DDF8

Connections:
/3V3: C17.1, C19.1, R17.1, R18.1, U3.1 (A1), U3.2 (A0), U3.6 (VS), U4.5 (OUT)
/5V_PI: BEC1.3, TP1.1
/5V_Servo: J3.3, J5.2, J6.2, J7.2
/9V_DJI: J10.3, J11.1
/9V_Servo: J4.3, J8.2
/BAT_FUSED: C20.2, C21.1, D2.1 (A1), F1.2, J1.1, Q1.3 (S), Q2.3 (S), Q3.3 (S), Q4.3 (S), R14.2, U5.1 (EN), U5.5 (VS), U5.8 (SRC)
/BST: C7.2, U1.20 (BST)
/BUCK_BIAS: C5.2, U1.1 (VCC)
/CHARGE_PUMP: C20.1, U5.4 (VCAP)
/COMP: C11.1, R7.1, U1.6 (COMP)
/COMP_RC: C12.1, R7.2
/Current: RL1.1, TP2.1, U2.1 (OUT)
/DIG_SENSE_N: C16.2, R16.2, U3.9 (IN-)
/DIG_SENSE_P: C16.1, R15.2, U3.10 (IN+)
/FB: C11.2, C12.2, R5.2, R6.1, U1.7 (FB)
/GATE_Q1: Q1.1 (G), R12.2
/GATE_Q2: Q2.1 (G), R19.2
/GATE_Q3: Q3.1 (G), R20.2
/GATE_Q4: Q4.1 (G), R21.2
/GNDA: C3.1, C4.1, C6.1, C14.2, C15.2, C17.2, C18.2, C19.2, NT1.1, R2.1, R4.1, R6.2, R9.2, RL1.2, U1.10 (AGND), U2.2 (GND), U3.7 (GND), U4.2 (GND)
/IS_RETURN: D1.2 (A), R3.2, U1.15 (IS_2), U1.16 (IS)
/LED_A: D3.2 (A), R13.2
/NMOS_DRIVE: R12.1, R14.1, R19.1, R20.1, R21.1, U5.6 (GATE)
/PGND: BEC1.2, BEC1.4, BT1.2, C1.1, C2.1, C5.1, C9.2, C10.2, C13.2, C21.2, D2.2 (A2), D3.1 (K), J1.2, J2.5, J2.6, J3.2, J3.4, J4.2, J4.4, J5.3, J6.3, J7.3, J8.3, J10.2, J10.4, J11.2, J12.2, NT1.2, U1.13 (PGND_2), U1.14 (PGND), U1.21 (EP), U5.2 (GND), U5.7 (OV)
/RAMP: C3.2, U1.9 (RAMP)
/RT: R4.2, U1.8 (RT)
/SCL: J2.3, R17.2, U3.5 (SCL)
/SD: C4.2, R1.2, R2.2, U1.2 (SD)
/SDA: J2.4, R18.2, U3.4 (SDA)
/SENSE_N: NT3.2, R16.1, U2.4 (VIN-)
/SENSE_P: NT2.2, R15.1, U2.3 (VIN+)
/SNUB: C8.2, R3.1
/SS: C6.2, U1.11 (SS)
/SW: C7.1, C8.1, D1.1 (K), L1.2, U1.17 (SW_2), U1.18 (SW), U1.19 (PRE)
/VCC: NT2.1, Q1.2 (D), Q2.2 (D), Q3.2 (D), Q4.2 (D), R10.1, R11.1
/Vin: BEC1.1, C1.2, C2.2, C13.1, J3.1, J4.1, J10.1, J12.1, NT3.1, R1.1, R8.1, R10.2, R11.2, U1.3 (VIN_2), U1.4 (VIN), U3.8 (VBUS)
/Voltage: C15.1, R8.2, R9.1, TP3.1
/out: C9.1, C10.1, C14.1, C18.1, J2.1, J2.2, L1.1, R5.1, R13.1, U1.12 (OUT), U2.5 (V+), U4.1 (IN), U4.3 (EN)
unnamed: BT1.1, F1.1

Notes on the sheet:
POWER PATH - NOT RELEASED FOR 50A
BUCK POWER
BUCK CONTROL
ANALOG TEST AND KELVIN INTERFACES
EXTERNAL BEC AND SERVO INTERFACES
PIXHAWK 6X DIGITAL TELEMETRY / I2C 0x45
4S NMOS REVERSE PROTECTION / NO INRUSH LIMIT
42 x 42 mm target. No manufacturing release until thermal and power-path redesign is resolved.
J2: 1/2=5V, 3=SCL, 4=SDA, 5/6=PGND. Pixhawk 6X digital power interface.
Servo pin 1: intentional NC. PWM must come from FC harness; this PCB distributes servo power only.
NT2/NT3: dedicated Kelvin pickup at symmetric shunt terminals; no load current in SENSE_P/N.
NT1: PGND/GNDA single PCB bond adjacent to U1 EP. Keep FC power return off GNDA.
F1 is in the external battery harness ahead of J1. DJI rail is 9V from external BEC.

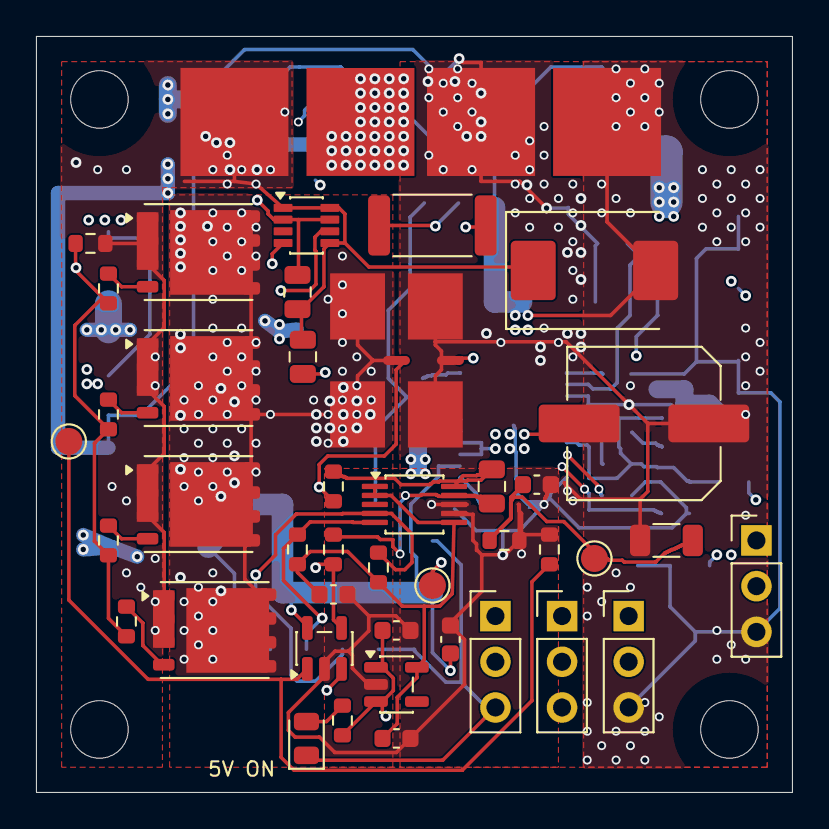
[picture p42: board PDB_50A.kicad_pcb from above]

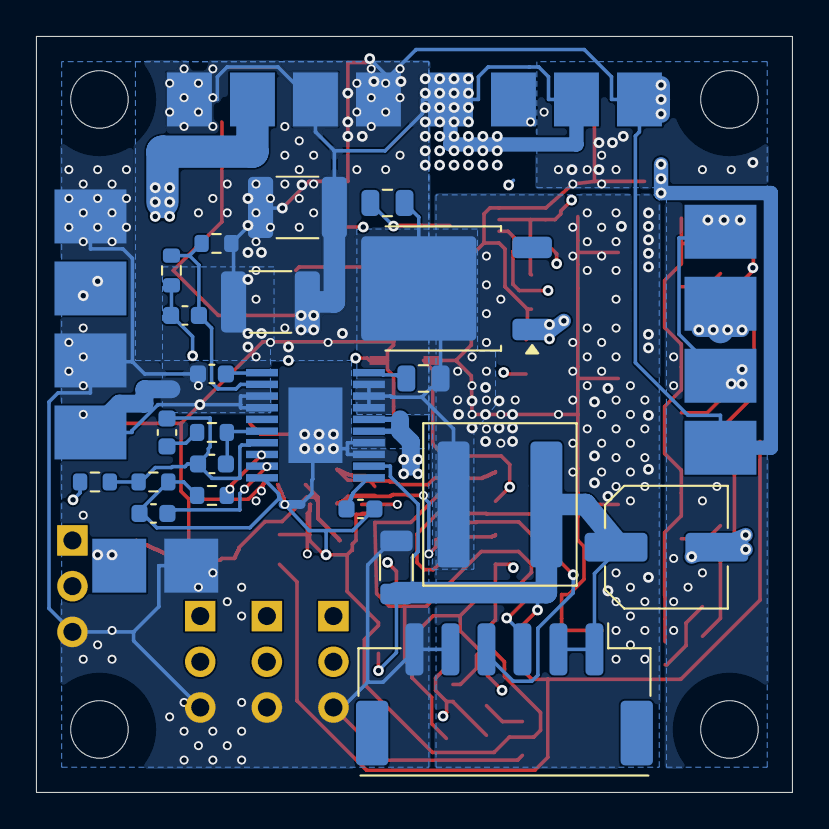
[picture p43: board PDB_50A.kicad_pcb from below]

Board: 4 copper layers, 42.0 x 42.0 mm, 78 parts (28 on the bottom side), 38 nets.

Other parts of the board:
H1, H2, H3, H4: M3 3.2mm NPTH; MountingHole_3.2mm_M3
